diekhans/pycbio/tests/progtests/sra/input/SRX14530460-SraRunInfo.csv

Run | ReleaseDate | LoadDate | spots | bases | spots_with_mates | avgLength | size_MB | AssemblyName | download_path | Experiment | LibraryName | LibraryStrategy | LibrarySelection | LibrarySource | LibraryLayout | InsertSize | InsertDev | Platform | Model | SRAStudy | BioProject | Study_Pubmed_id | ProjectID | Sample | BioSample | SampleType | TaxID | ScientificName | SampleName | g1k_pop_code | source | g1k_analysis_group | Subject_ID | Sex | Disease | Tumor | Affection_Status | Analyte_Type | Histological_Type | Body_Site | CenterName | Submission | dbgap_study_accession | Consent | RunHash | ReadHash
SRR18396502 | 2022-03-22 02:52:43 | 2022-03-21 11:46:57 | 176 | 26686 | 176 | 151 | 0 |  | https://sra-downloadb.be-md.ncbi.nlm.nih.gov/sos9/sra-pub-zq-924/SRR018/18396/SRR18396502/SRR18396502.lite.1 | SRX14530460 | pYES_BRCA_A_pH3 | RNA-Seq | RANDOM | TRANSCRIPTOMIC | PAIRED | 0 | 0 | ILLUMINA | NextSeq 500 | SRP365043 | PRJNA818194 |  | 818194 | SRS12327854 | SAMN26849332 | simple | 4932 | Saccharomyces cerevisiae | pYES_BRCA_A_pH3 |  |  |  |  |  |  | no |  |  |  |  | NATIONAL RESEARCH COUNCIL OF ITALY (CNR) | SRA1388950 |  | public | F7598EDAF03B7869CC7042EFEC8C694F | 543D294AB70618099D481EB79116D204
