diekhans/pycbio/tests/progtests/sra/input/SRX2013614-SraRunInfo.tsv

Run | ReleaseDate | LoadDate | spots | bases | spots_with_mates | avgLength | size_MB | AssemblyName | download_path | Experiment | LibraryName | LibraryStrategy | LibrarySelection | LibrarySource | LibraryLayout | InsertSize | InsertDev | Platform | Model | SRAStudy | BioProject | Study_Pubmed_id | ProjectID | Sample | BioSample | SampleType | TaxID | ScientificName | SampleName | g1k_pop_code | source | g1k_analysis_group | Subject_ID | Sex | Disease | Tumor | Affection_Status | Analyte_Type | Histological_Type | Body_Site | CenterName | Submission | dbgap_study_accession | Consent | RunHash | ReadHash
SRR4020133 | 2020-04-17 16:24:12 | 2016-11-01 14:22:40 | 393 | 39300 | 0 | 100 | 0 |  | https://sra-downloadb.be-md.ncbi.nlm.nih.gov/sos9/sra-pub-zq-922/SRR004/020/SRR4020133.sralite.1 | SRX2013614 |  | RNA-Seq | cDNA | TRANSCRIPTOMIC | SINGLE | 0 | 0 | ILLUMINA | Illumina HiSeq 2000 | SRP066860 | PRJNA304636 | 2 | 304636 | SRS1610588 | SAMN05560693 | simple | 4932 | Saccharomyces cerevisiae | GSM2268808 |  |  |  |  |  |  | no |  |  |  |  | GEO | SRA314391 |  | public | DBCDDD40115BEA512B414762005C0D5A | 3C6D3D4D87669E3AC93E930605D94CEF
