diekhans/pycbio/tests/progtests/csv-to-tsv/input/sra-run-semi.csv

Run | ReleaseDate | LoadDate | spots | bases | spots_with_mates | avgLength | size_MB | AssemblyName | download_path | Experiment | LibraryName | LibraryStrategy | LibrarySelection | LibrarySource | LibraryLayout | InsertSize | InsertDev | Platform | Model | SRAStudy | BioProject | Study_Pubmed_id | ProjectID | Sample | BioSample | SampleType | TaxID | ScientificName | SampleName | g1k_pop_code | source | g1k_analysis_group | Subject_ID | Sex | Disease | Tumor | Affection_Status | Analyte_Type | Histological_Type | Body_Site | CenterName | Submission | dbgap_study_accession | Consent | RunHash | ReadHash
DRR030359 | 2017-02-28 | 2017-02-28 | 67386940 | 6806080940 | 0 | 101 | 4206 |  | https://sra-download.ncbi.nlm.nih.gov/srapub/DRR030359 | DRX027375 | RNA-seq of F2-4A mouse liver | RNA-Seq | cDNA | TRANSCRIPTOMIC | SINGLE | 0 | 0 | ILLUMINA | Illumina HiSeq 2000 | DRP003496 | PRJDB3525 |  | 368837 | DRS041181 | SAMD00026056 | simple | 10090 | Mus musculus | SAMD00026056 |  |  |  |  | male |  | no |  |  |  |  | NAGOYA | DRA003057 |  | public | A9EF6C7C9B6BA92CF5AF50D536C88866 | 65BE9BBF3D7D514DF2FD9F9DA25957C1
DRR030360 | 2017-02-28 | 2017-02-28 | 59278224 | 5987100624 | 0 | 101 | 3702 |  | https://sra-download.ncbi.nlm.nih.gov/srapub/DRR030360 | DRX027376 | RNA-seq of F2-4B mouse liver | RNA-Seq | cDNA | TRANSCRIPTOMIC | SINGLE | 0 | 0 | ILLUMINA | Illumina HiSeq 2000 | DRP003496 | PRJDB3525 |  | 368837 | DRS041182 | SAMD00026057 | simple | 10090 | Mus musculus | SAMD00026057 |  |  |  |  | male |  | no |  |  |  |  | NAGOYA | DRA003057 |  | public | 67EC2E6DB3629CE509964D6E7BF2C341 | 3788A7E7B8208792A841A63F96753AA1
DRR030361 | 2017-02-28 | 2017-02-28 | 73682031 | 7441885131 | 0 | 101 | 4599 |  | https://sra-download.ncbi.nlm.nih.gov/srapub/DRR030361 | DRX027377 | RNA-seq of F2-4D mouse liver | RNA-Seq | cDNA | TRANSCRIPTOMIC | SINGLE | 0 | 0 | ILLUMINA | Illumina HiSeq 2000 | DRP003496 | PRJDB3525 |  | 368837 | DRS041183 | SAMD00026058 | simple | 10090 | Mus musculus | SAMD00026058 |  |  |  |  | male |  | no |  |  |  |  | NAGOYA | DRA003057 |  | public | 5F72EDE34E3DF5FE5D215526F7F37DA9 | 6054E11B177B0662218E2DFAC80FE5D6
DRR030362 | 2017-02-28 | 2017-02-28 | 69622818 | 7031904618 | 0 | 101 | 4391 |  | https://sra-download.ncbi.nlm.nih.gov/srapub/DRR030362 | DRX027378 | RNA-seq of F2-4A5C21A pooled mouse gonadal fat pads | RNA-Seq | cDNA | TRANSCRIPTOMIC | SINGLE | 0 | 0 | ILLUMINA | Illumina HiSeq 2000 | DRP003496 | PRJDB3525 |  | 368837 | DRS041184 | SAMD00026059 | simple | 10090 | Mus musculus | SAMD00026059 |  |  |  |  | male |  | no |  |  |  |  | NAGOYA | DRA003057 |  | public | CE63E1D090AE9165CD200755D6786BE2 | DAAA783AF21215D5C712F64F52BB260B
DRR030363 | 2017-02-28 | 2017-02-28 | 83051167 | 8388167867 | 0 | 101 | 5229 |  | https://sra-download.ncbi.nlm.nih.gov/srapub/DRR030363 | DRX027379 | RNA-seq of F2-4B5A21B mouse pooled gonadal fat pads | RNA-Seq | cDNA | TRANSCRIPTOMIC | SINGLE | 0 | 0 | ILLUMINA | Illumina HiSeq 2000 | DRP003496 | PRJDB3525 |  | 368837 | DRS041185 | SAMD00026060 | simple | 10090 | Mus musculus | SAMD00026060 |  |  |  |  | male |  | no |  |  |  |  | NAGOYA | DRA003057 |  | public | C6BF1D1B9DEFED534A11972ED241C485 | 16D035E735B4D057D60C4FBA0FE3367D
DRR030364 | 2017-02-28 | 2017-02-28 | 52629776 | 5315607376 | 0 | 101 | 3333 |  | https://sra-download.ncbi.nlm.nih.gov/srapub/DRR030364 | DRX027380 | RNA-seq of F2-4D5B21C mouse pooled gonadal fat pads | RNA-Seq | cDNA | TRANSCRIPTOMIC | SINGLE | 0 | 0 | ILLUMINA | Illumina HiSeq 2000 | DRP003496 | PRJDB3525 |  | 368837 | DRS041186 | SAMD00026061 | simple | 10090 | Mus musculus | SAMD00026061 |  |  |  |  | male |  | no |  |  |  |  | NAGOYA | DRA003057 |  | public | 043E079DE11792123B221DAC8B3CF050 | B0D448B5A3701469AABD93E959F1597E
DRR030403 | 2017-02-28 | 2017-02-28 | 30977007 | 6257355414 | 30977007 | 202 | 4125 |  | https://sra-download.ncbi.nlm.nih.gov/srapub/DRR030403 | DRX027419 | Mouse embryonic stem cells exposed to p-DCB | RNA-Seq | RANDOM | TRANSCRIPTOMIC | PAIRED | 200 | 0 | ILLUMINA | Illumina HiSeq 2000 | DRP003476 | PRJDB3516 |  | 375918 | DRS041039 | SAMD00026224 | simple | 10090 | Mus musculus | SAMD00026224 |  |  |  |  | male |  | no |  |  |  |  | AIST | DRA003065 |  | public | B8D906BE71B279512D06296E527EB84D | B0EC587F73F5D2B26CAB08C98E7AD8DF
DRR030404 | 2017-02-28 | 2017-02-28 | 44267986 | 8942133172 | 44267986 | 202 | 5602 |  | https://sra-download.ncbi.nlm.nih.gov/srapub/DRR030404 | DRX027420 | Mouse embryonic stem cells exposed to p-DCB | RNA-Seq | RANDOM | TRANSCRIPTOMIC | PAIRED | 200 | 0 | ILLUMINA | Illumina HiSeq 2000 | DRP003476 | PRJDB3516 |  | 375918 | DRS041040 | SAMD00026225 | simple | 10090 | Mus musculus | SAMD00026225 |  |  |  |  | male |  | no |  |  |  |  | AIST | DRA003065 |  | public | 19C72E4B6412F2EE6384A9BFD42AD8F1 | 4DDC54A62C3C6853995E541F08011AF8
DRR030405 | 2017-02-28 | 2017-02-28 | 30473895 | 6155726790 | 30473895 | 202 | 3843 |  | https://sra-download.ncbi.nlm.nih.gov/srapub/DRR030405 | DRX027421 | Mouse embryonic stem cells exposed to p-DCB | RNA-Seq | RANDOM | TRANSCRIPTOMIC | PAIRED | 200 | 0 | ILLUMINA | Illumina HiSeq 2000 | DRP003476 | PRJDB3516 |  | 375918 | DRS041041 | SAMD00026226 | simple | 10090 | Mus musculus | SAMD00026226 |  |  |  |  | male |  | no |  |  |  |  | AIST | DRA003065 |  | public | B3F0F26813CB275A0B6D0A0AFB2ABE26 | CCED742E79A3F0D0BBD72224F35FDDCB
DRR030406 | 2017-02-28 | 2017-02-28 | 41774744 | 8438498288 | 41774744 | 202 | 5561 |  | https://sra-download.ncbi.nlm.nih.gov/srapub/DRR030406 | DRX027422 | Mouse embryonic stem cells exposed to p-DCB | RNA-Seq | RANDOM | TRANSCRIPTOMIC | PAIRED | 200 | 0 | ILLUMINA | Illumina HiSeq 2000 | DRP003476 | PRJDB3516 |  | 375918 | DRS041042 | SAMD00026227 | simple | 10090 | Mus musculus | SAMD00026227 |  |  |  |  | male |  | no |  |  |  |  | AIST | DRA003065 |  | public | 82CB036F26A21C366ED9ED5D5EF80336 | B58FD251C068A376AF0188D0F556FA5C
DRR030407 | 2017-02-28 | 2017-02-28 | 32214045 | 6507237090 | 32214045 | 202 | 4267 |  | https://sra-download.ncbi.nlm.nih.gov/srapub/DRR030407 | DRX027423 | Mouse embryonic stem cells exposed to p-DCB | RNA-Seq | RANDOM | TRANSCRIPTOMIC | PAIRED | 200 | 0 | ILLUMINA | Illumina HiSeq 2000 | DRP003476 | PRJDB3516 |  | 375918 | DRS041043 | SAMD00026228 | simple | 10090 | Mus musculus | SAMD00026228 |  |  |  |  | male |  | no |  |  |  |  | AIST | DRA003065 |  | public | 0F7CF206CDC43FAC9C19B92023FA8DE8 | A16015A0D5D1B24A15DCDB99592F73C2
DRR030408 | 2017-02-28 | 2017-02-28 | 37137309 | 7501736418 | 37137309 | 202 | 4942 |  | https://sra-download.ncbi.nlm.nih.gov/srapub/DRR030408 | DRX027424 | Mouse embryonic stem cells exposed to p-DCB | RNA-Seq | RANDOM | TRANSCRIPTOMIC | PAIRED | 200 | 0 | ILLUMINA | Illumina HiSeq 2000 | DRP003476 | PRJDB3516 |  | 375918 | DRS041044 | SAMD00026229 | simple | 10090 | Mus musculus | SAMD00026229 |  |  |  |  | male |  | no |  |  |  |  | AIST | DRA003065 |  | public | 7B050B6A07046EE08492093827C53CB5 | 9540D8496598CAB2D9B92B6889891E1E
DRR030409 | 2017-02-28 | 2017-02-28 | 30688033 | 6198982666 | 30688033 | 202 | 3840 |  | https://sra-download.ncbi.nlm.nih.gov/srapub/DRR030409 | DRX027425 | Mouse embryonic stem cells exposed to p-DCB | RNA-Seq | RANDOM | TRANSCRIPTOMIC | PAIRED | 200 | 0 | ILLUMINA | Illumina HiSeq 2000 | DRP003476 | PRJDB3516 |  | 375918 | DRS041045 | SAMD00026230 | simple | 10090 | Mus musculus | SAMD00026230 |  |  |  |  | male |  | no |  |  |  |  | AIST | DRA003065 |  | public | 4712494C8A6A20F59CF1F177153B8E5B | 3990B589E256D597C11A7C0EE7A34FC1
DRR030410 | 2017-02-28 | 2017-02-28 | 31631058 | 6389473716 | 31631058 | 202 | 3974 |  | https://sra-download.ncbi.nlm.nih.gov/srapub/DRR030410 | DRX027426 | Mouse embryonic stem cells exposed to p-DCB | RNA-Seq | RANDOM | TRANSCRIPTOMIC | PAIRED | 200 | 0 | ILLUMINA | Illumina HiSeq 2000 | DRP003476 | PRJDB3516 |  | 375918 | DRS041046 | SAMD00026231 | simple | 10090 | Mus musculus | SAMD00026231 |  |  |  |  | male |  | no |  |  |  |  | AIST | DRA003065 |  | public | 648B0D913859F41D321E44245E8CF6B2 | 881E8981EDC6FA3C1B0D9201E7FAB84E
DRR051357 | 2017-02-28 | 2017-02-28 | 33459036 | 1204525296 | 0 | 36 | 598 |  | https://sra-download.ncbi.nlm.nih.gov/srapub/DRR051357 | DRX046249 |  | RNA-Seq | cDNA | TRANSCRIPTOMIC | SINGLE | 0 | 0 | ILLUMINA | Illumina Genome Analyzer IIx | DRP003489 | PRJDB4477 |  | 376153 | DRS041060 | SAMD00045276 | simple | 10090 | Mus musculus | SAMD00045276 |  |  |  |  |  |  | no |  |  |  |  | HIROSHIMA | DRA004283 |  | public | 5ADF18D6D67F43321CEED2B1791EB740 | FD5AE4873C019F1D491A7262AD0F48A8
DRR051358 | 2017-02-28 | 2017-02-28 | 24320514 | 875538504 | 0 | 36 | 406 |  | https://sra-download.ncbi.nlm.nih.gov/srapub/DRR051358 | DRX046250 |  | RNA-Seq | cDNA | TRANSCRIPTOMIC | SINGLE | 0 | 0 | ILLUMINA | Illumina Genome Analyzer IIx | DRP003489 | PRJDB4477 |  | 376153 | DRS041061 | SAMD00045277 | simple | 10090 | Mus musculus | SAMD00045277 |  |  |  |  |  |  | no |  |  |  |  | HIROSHIMA | DRA004283 |  | public | 0FC3A87807D2DB5D879AFB9D021C9F5F | 82706BD2E0EA0303DB8B649A834C8D61
ERR1745401 | 2017-02-28 | 2017-02-28 | 54471972 | 2723598600 | 0 | 50 | 1170 |  | https://sra-download.ncbi.nlm.nih.gov/srapub/ERR1745401 | ERX1814615 | T0_2i_rRNA_s | RNA-Seq | Inverse rRNA | TRANSCRIPTOMIC | SINGLE | 0 | 0 | ILLUMINA | Illumina Genome Analyzer IIx | ERP020389 | PRJEB18460 |  | 376717 | ERS1463303 | SAMEA18891418 | simple | 10090 | Mus musculus | house mouse |  |  |  |  |  |  | no |  |  |  |  | Stunnenberg | ERA770777 |  | public | E0B9FD26C5352C601F8B5178D8ABBBB5 | CC6E0B25B15CFA08A68AA6D4F10CEE58
ERR1745402 | 2017-02-28 | 2017-02-28 | 50534105 | 2526705250 | 0 | 50 | 1089 |  | https://sra-download.ncbi.nlm.nih.gov/srapub/ERR1745402 | ERX1814616 | T1_16h_rRNA_s | RNA-Seq | Inverse rRNA | TRANSCRIPTOMIC | SINGLE | 0 | 0 | ILLUMINA | Illumina Genome Analyzer IIx | ERP020389 | PRJEB18460 |  | 376717 | ERS1463304 | SAMEA18892168 | simple | 10090 | Mus musculus | house mouse |  |  |  |  |  |  | no |  |  |  |  | Stunnenberg | ERA770777 |  | public | 327B5B421C1D11B259C51929BF9C32BE | 23012873842542BD4418444E83A601D9
ERR1745403 | 2017-02-28 | 2017-02-28 | 49251393 | 2462569650 | 0 | 50 | 1059 |  | https://sra-download.ncbi.nlm.nih.gov/srapub/ERR1745403 | ERX1814617 | T2_Rex1high_rRNA_s | RNA-Seq | Inverse rRNA | TRANSCRIPTOMIC | SINGLE | 0 | 0 | ILLUMINA | Illumina Genome Analyzer IIx | ERP020389 | PRJEB18460 |  | 376717 | ERS1463305 | SAMEA18892918 | simple | 10090 | Mus musculus | house mouse |  |  |  |  |  |  | no |  |  |  |  | Stunnenberg | ERA770777 |  | public | 91AC49806492D344C6AE47D3F927BF5E | AB5865F4CA1589C22D7764C99C9FFE7B
ERR1745404 | 2017-02-28 | 2017-02-28 | 48733321 | 2436666050 | 0 | 50 | 1051 |  | https://sra-download.ncbi.nlm.nih.gov/srapub/ERR1745404 | ERX1814618 | T2_Rex1low_rRNA_s | RNA-Seq | Inverse rRNA | TRANSCRIPTOMIC | SINGLE | 0 | 0 | ILLUMINA | Illumina Genome Analyzer IIx | ERP020389 | PRJEB18460 |  | 376717 | ERS1463306 | SAMEA18893668 | simple | 10090 | Mus musculus | house mouse |  |  |  |  |  |  | no |  |  |  |  | Stunnenberg | ERA770777 |  | public | 79C45E75887D14B602FB5C6A9819CDD8 | C58649A36B3090B768E1A8AF10048EB2
ERR1745405 | 2017-02-28 | 2017-02-28 | 30868986 | 1080414510 | 0 | 35 | 1227 |  | https://sra-download.ncbi.nlm.nih.gov/srapub/ERR1745405 | ERX1814619 | T0_2i_polyA_s | RNA-Seq | Oligo-dT | TRANSCRIPTOMIC | SINGLE | 0 | 0 | ILLUMINA | Illumina Genome Analyzer IIx | ERP020389 | PRJEB18460 |  | 376717 | ERS1463307 | SAMEA18894418 | simple | 10090 | Mus musculus | house mouse |  |  |  |  |  |  | no |  |  |  |  | Stunnenberg | ERA770777 |  | public | C33A70992316F4C4ABBF6110B50F99D4 | 8BAD599B7EFC9ED9BB0F1E23C75EB23B
ERR1745406 | 2017-02-28 | 2017-02-28 | 28173501 | 986072535 | 0 | 35 | 1090 |  | https://sra-download.ncbi.nlm.nih.gov/srapub/ERR1745406 | ERX1814620 | T1_16h_polyA_s | RNA-Seq | Oligo-dT | TRANSCRIPTOMIC | SINGLE | 0 | 0 | ILLUMINA | Illumina Genome Analyzer IIx | ERP020389 | PRJEB18460 |  | 376717 | ERS1463308 | SAMEA18895168 | simple | 10090 | Mus musculus | house mouse |  |  |  |  |  |  | no |  |  |  |  | Stunnenberg | ERA770777 |  | public | 90C3736CF9670C8FDE02B3264BE1EB94 | 79FF20D2A53EB2C6DE979A948C815530
ERR1745407 | 2017-02-28 | 2017-02-28 | 25362653 | 887692855 | 0 | 35 | 972 |  | https://sra-download.ncbi.nlm.nih.gov/srapub/ERR1745407 | ERX1814621 | T2_Rex1high_polyA_s | RNA-Seq | Oligo-dT | TRANSCRIPTOMIC | SINGLE | 0 | 0 | ILLUMINA | Illumina Genome Analyzer IIx | ERP020389 | PRJEB18460 |  | 376717 | ERS1463309 | SAMEA18895918 | simple | 10090 | Mus musculus | house mouse |  |  |  |  |  |  | no |  |  |  |  | Stunnenberg | ERA770777 |  | public | D19003AAC88B36C5824887B72ECCD9FB | 16AECB2E2EDF705F261346F84B7496F0
ERR1745408 | 2017-02-28 | 2017-02-28 | 24241853 | 848464855 | 0 | 35 | 938 |  | https://sra-download.ncbi.nlm.nih.gov/srapub/ERR1745408 | ERX1814622 | T2_Rex1low_polyA_s | RNA-Seq | Oligo-dT | TRANSCRIPTOMIC | SINGLE | 0 | 0 | ILLUMINA | Illumina Genome Analyzer IIx | ERP020389 | PRJEB18460 |  | 376717 | ERS1463310 | SAMEA18896668 | simple | 10090 | Mus musculus | house mouse |  |  |  |  |  |  | no |  |  |  |  | Stunnenberg | ERA770777 |  | public | 53EE181A4F66B15FC16B7CF67FAA8403 | 8346835212ADE75314C17C24A5BE4DE9
ERR1813629 | 2017-02-22 | 2017-02-24 | 23406637 | 2949236262 | 0 | 126 | 1014 |  | https://sra-download.ncbi.nlm.nih.gov/srapub/ERR1813629 | ERX1876166 | Sample 1_s | RNA-Seq | RANDOM PCR | TRANSCRIPTOMIC | SINGLE | 0 | 0 | ILLUMINA | Illumina HiSeq 4000 | ERP021240 | PRJEB19251 |  | 376299 | ERS1531700 | SAMEA70189168 | simple | 10090 | Mus musculus | house mouse |  |  |  |  |  |  | no |  |  |  |  | Sabine Spath, Florian Mair | ERA804242 |  | public | 27F76AE2FB1D4D9D9527CC4F34D57D4C | 00E53A6D43E34410FD92E927D4165368
ERR1813630 | 2017-02-22 | 2017-02-24 | 19059035 | 2401438410 | 0 | 126 | 824 |  | https://sra-download.ncbi.nlm.nih.gov/srapub/ERR1813630 | ERX1876167 | Sample 10_s | RNA-Seq | RANDOM PCR | TRANSCRIPTOMIC | SINGLE | 0 | 0 | ILLUMINA | Illumina HiSeq 4000 | ERP021240 | PRJEB19251 |  | 376299 | ERS1531701 | SAMEA70189918 | simple | 10090 | Mus musculus | house mouse |  |  |  |  |  |  | no |  |  |  |  | Sabine Spath, Florian Mair | ERA804242 |  | public | 61A0360CEAEE64B2E77C5F2029DF6020 | DA47B29AE64DE9F2C839AD0679D0922D
ERR1813631 | 2017-02-22 | 2017-02-24 | 22985083 | 2896120458 | 0 | 126 | 1000 |  | https://sra-download.ncbi.nlm.nih.gov/srapub/ERR1813631 | ERX1876168 | Sample 11_s | RNA-Seq | RANDOM PCR | TRANSCRIPTOMIC | SINGLE | 0 | 0 | ILLUMINA | Illumina HiSeq 4000 | ERP021240 | PRJEB19251 |  | 376299 | ERS1531702 | SAMEA70190668 | simple | 10090 | Mus musculus | house mouse |  |  |  |  |  |  | no |  |  |  |  | Sabine Spath, Florian Mair | ERA804242 |  | public | 96E908FE4834A672C34C88D77DB03CBA | 863BEC0DFA3B775FAC696BCDD07C638B
ERR1813632 | 2017-02-22 | 2017-02-24 | 31039729 | 3911005854 | 0 | 126 | 1339 |  | https://sra-download.ncbi.nlm.nih.gov/srapub/ERR1813632 | ERX1876169 | Sample 12_s | RNA-Seq | RANDOM PCR | TRANSCRIPTOMIC | SINGLE | 0 | 0 | ILLUMINA | Illumina HiSeq 4000 | ERP021240 | PRJEB19251 |  | 376299 | ERS1531703 | SAMEA70191418 | simple | 10090 | Mus musculus | house mouse |  |  |  |  |  |  | no |  |  |  |  | Sabine Spath, Florian Mair | ERA804242 |  | public | F554B8264332854A8053B117D12F21A5 | 2160CBCD12BB1F0809BA74E1875C989F
ERR1813633 | 2017-02-22 | 2017-02-22 | 0 | 0 | 0 | 0 | 0 |  |  | ERX1876170 | Sample 13_s | RNA-Seq | RANDOM PCR | TRANSCRIPTOMIC | SINGLE | 0 | 0 | ILLUMINA | Illumina HiSeq 4000 | ERP021240 | PRJEB19251 |  | 376299 | ERS1531704 | SAMEA70192168 | simple | 10090 | Mus musculus | house mouse |  |  |  |  |  |  | no |  |  |  |  | Sabine Spath, Florian Mair | ERA804242 |  | public
ERR1813634 | 2017-02-22 | 2017-02-24 | 21614397 | 2723414022 | 0 | 126 | 933 |  | https://sra-download.ncbi.nlm.nih.gov/srapub/ERR1813634 | ERX1876171 | Sample 14_s | RNA-Seq | RANDOM PCR | TRANSCRIPTOMIC | SINGLE | 0 | 0 | ILLUMINA | Illumina HiSeq 4000 | ERP021240 | PRJEB19251 |  | 376299 | ERS1531705 | SAMEA70192918 | simple | 10090 | Mus musculus | house mouse |  |  |  |  |  |  | no |  |  |  |  | Sabine Spath, Florian Mair | ERA804242 |  | public | DC80D5D3675F8F5B6F9D663286739043 | A880C57371FB07F63CFC6DAAC3A1C952
ERR1813635 | 2017-02-22 | 2017-02-24 | 23276491 | 2932837866 | 0 | 126 | 1014 |  | https://sra-download.ncbi.nlm.nih.gov/srapub/ERR1813635 | ERX1876172 | Sample 15_s | RNA-Seq | RANDOM PCR | TRANSCRIPTOMIC | SINGLE | 0 | 0 | ILLUMINA | Illumina HiSeq 4000 | ERP021240 | PRJEB19251 |  | 376299 | ERS1531706 | SAMEA70193668 | simple | 10090 | Mus musculus | house mouse |  |  |  |  |  |  | no |  |  |  |  | Sabine Spath, Florian Mair | ERA804242 |  | public | C8FCD3188BBCF75F4D64EF79C0A24192 | 233C9A9B85A38E113E319D00CA7AB678
ERR1813636 | 2017-02-22 | 2017-02-24 | 24888387 | 3135936762 | 0 | 126 | 1073 |  | https://sra-download.ncbi.nlm.nih.gov/srapub/ERR1813636 | ERX1876173 | Sample 2_s | RNA-Seq | RANDOM PCR | TRANSCRIPTOMIC | SINGLE | 0 | 0 | ILLUMINA | Illumina HiSeq 4000 | ERP021240 | PRJEB19251 |  | 376299 | ERS1531707 | SAMEA70194418 | simple | 10090 | Mus musculus | house mouse |  |  |  |  |  |  | no |  |  |  |  | Sabine Spath, Florian Mair | ERA804242 |  | public | 091BE68E489E757A7459EDCEB433612E | 131F7F531C5C6896DBE2900880871584
ERR1813637 | 2017-02-22 | 2017-02-24 | 19853672 | 2501562672 | 0 | 126 | 857 |  | https://sra-download.ncbi.nlm.nih.gov/srapub/ERR1813637 | ERX1876174 | Sample 3_s | RNA-Seq | RANDOM PCR | TRANSCRIPTOMIC | SINGLE | 0 | 0 | ILLUMINA | Illumina HiSeq 4000 | ERP021240 | PRJEB19251 |  | 376299 | ERS1531708 | SAMEA70195168 | simple | 10090 | Mus musculus | house mouse |  |  |  |  |  |  | no |  |  |  |  | Sabine Spath, Florian Mair | ERA804242 |  | public | 177BE77A02C02FED3970A4EA2B8ACCB7 | 2C7822D3AC276004A367E842DEF863C6
ERR1813638 | 2017-02-22 | 2017-02-24 | 32704496 | 4120766496 | 0 | 126 | 1434 |  | https://sra-download.ncbi.nlm.nih.gov/srapub/ERR1813638 | ERX1876175 | Sample 4_s | RNA-Seq | RANDOM PCR | TRANSCRIPTOMIC | SINGLE | 0 | 0 | ILLUMINA | Illumina HiSeq 4000 | ERP021240 | PRJEB19251 |  | 376299 | ERS1531709 | SAMEA70195918 | simple | 10090 | Mus musculus | house mouse |  |  |  |  |  |  | no |  |  |  |  | Sabine Spath, Florian Mair | ERA804242 |  | public | 4482D2C561C86F1DCF68ED728A711325 | CA369FD925F8F7187D75BA77EA2E958F
ERR1813639 | 2017-02-22 | 2017-02-24 | 31852025 | 4013355150 | 0 | 126 | 1408 |  | https://sra-download.ncbi.nlm.nih.gov/srapub/ERR1813639 | ERX1876176 | Sample 5_s | RNA-Seq | RANDOM PCR | TRANSCRIPTOMIC | SINGLE | 0 | 0 | ILLUMINA | Illumina HiSeq 4000 | ERP021240 | PRJEB19251 |  | 376299 | ERS1531710 | SAMEA70196668 | simple | 10090 | Mus musculus | house mouse |  |  |  |  |  |  | no |  |  |  |  | Sabine Spath, Florian Mair | ERA804242 |  | public | 743AF927190515BE9420203FFCE71CCF | 3EFC93529E3558024493B5B4646D693A
ERR1813640 | 2017-02-22 | 2017-02-24 | 23150181 | 2916922806 | 0 | 126 | 1001 |  | https://sra-download.ncbi.nlm.nih.gov/srapub/ERR1813640 | ERX1876177 | Sample 6_s | RNA-Seq | RANDOM PCR | TRANSCRIPTOMIC | SINGLE | 0 | 0 | ILLUMINA | Illumina HiSeq 4000 | ERP021240 | PRJEB19251 |  | 376299 | ERS1531711 | SAMEA70197418 | simple | 10090 | Mus musculus | house mouse |  |  |  |  |  |  | no |  |  |  |  | Sabine Spath, Florian Mair | ERA804242 |  | public | 4676C949BBFCD59406EBC287C9AE0166 | E5725E2FB2360BAAE5EE3A4127942C0F
ERR1813641 | 2017-02-22 | 2017-02-24 | 21325633 | 2687029758 | 0 | 126 | 933 |  | https://sra-download.ncbi.nlm.nih.gov/srapub/ERR1813641 | ERX1876178 | Sample 7_s | RNA-Seq | RANDOM PCR | TRANSCRIPTOMIC | SINGLE | 0 | 0 | ILLUMINA | Illumina HiSeq 4000 | ERP021240 | PRJEB19251 |  | 376299 | ERS1531712 | SAMEA70198168 | simple | 10090 | Mus musculus | house mouse |  |  |  |  |  |  | no |  |  |  |  | Sabine Spath, Florian Mair | ERA804242 |  | public | 5AA9CD6F9D1B4FF85D946CBA1DC59200 | E19A7A4615DE1FEB3480FC22FFC2A149
ERR1813642 | 2017-02-22 | 2017-02-24 | 27935493 | 3519872118 | 0 | 126 | 1207 |  | https://sra-download.ncbi.nlm.nih.gov/srapub/ERR1813642 | ERX1876179 | Sample 8_s | RNA-Seq | RANDOM PCR | TRANSCRIPTOMIC | SINGLE | 0 | 0 | ILLUMINA | Illumina HiSeq 4000 | ERP021240 | PRJEB19251 |  | 376299 | ERS1531713 | SAMEA70198918 | simple | 10090 | Mus musculus | house mouse |  |  |  |  |  |  | no |  |  |  |  | Sabine Spath, Florian Mair | ERA804242 |  | public | F28D16553635121CD39E9512DAEBFE8F | B81F8CB71362DD41CFA8DAB01A9B39F6
ERR1813643 | 2017-02-22 | 2017-02-24 | 21224074 | 2674233324 | 0 | 126 | 918 |  | https://sra-download.ncbi.nlm.nih.gov/srapub/ERR1813643 | ERX1876180 | Sample 9_s | RNA-Seq | RANDOM PCR | TRANSCRIPTOMIC | SINGLE | 0 | 0 | ILLUMINA | Illumina HiSeq 4000 | ERP021240 | PRJEB19251 |  | 376299 | ERS1531714 | SAMEA70199668 | simple | 10090 | Mus musculus | house mouse |  |  |  |  |  |  | no |  |  |  |  | Sabine Spath, Florian Mair | ERA804242 |  | public | 26126EFFE80F8DEDED1A71CFCEF7A872 | 5AA887E15BF6BA013400FEDCD5C27EA8
ERR1827108 | 2017-02-21 | 2017-02-24 | 2862461 | 715615250 | 2862461 | 250 | 350 |  | https://sra-download.ncbi.nlm.nih.gov/srapub/ERR1827108 | ERX1889267 | do7528_p | RNA-Seq | cDNA | TRANSCRIPTOMIC | PAIRED | 737 | 479.787 | ILLUMINA | Illumina HiSeq 2500 | ERP016428 | PRJEB14760 |  | 330944 | ERS1549247 | SAMEA83349418 | simple | 10092 | Mus musculus domesticus | western European house mouse |  |  |  |  | male |  | no |  |  |  |  | CRUK Cambridge Institute Genomics Core Facility | ERA809577 |  | public | E03B6A99BB018B644E3985C2F378FECF | 1B33737649A487BF9B80B6A48DC92C99
ERR1827109 | 2017-02-21 | 2017-02-24 | 2854130 | 713532500 | 2854130 | 250 | 357 |  | https://sra-download.ncbi.nlm.nih.gov/srapub/ERR1827109 | ERX1889268 | do7529_p | RNA-Seq | cDNA | TRANSCRIPTOMIC | PAIRED | 737 | 479.787 | ILLUMINA | Illumina HiSeq 2500 | ERP016428 | PRJEB14760 |  | 330944 | ERS1549248 | SAMEA83350168 | simple | 10092 | Mus musculus domesticus | western European house mouse |  |  |  |  | male |  | no |  |  |  |  | CRUK Cambridge Institute Genomics Core Facility | ERA809577 |  | public | 783AB1B85D01C297B10F867BC5438397 | D170E5017629E99C374BBFCC37D88FF3
ERR1827110 | 2017-02-21 | 2017-02-24 | 3351296 | 837824000 | 3351296 | 250 | 416 |  | https://sra-download.ncbi.nlm.nih.gov/srapub/ERR1827110 | ERX1889269 | do7530_p | RNA-Seq | cDNA | TRANSCRIPTOMIC | PAIRED | 737 | 479.787 | ILLUMINA | Illumina HiSeq 2500 | ERP016428 | PRJEB14760 |  | 330944 | ERS1549249 | SAMEA83350918 | simple | 10092 | Mus musculus domesticus | western European house mouse |  |  |  |  | male |  | no |  |  |  |  | CRUK Cambridge Institute Genomics Core Facility | ERA809577 |  | public | B2FF24F5BE6200976BF431DD2445C747 | 6EB3F0C99415F3C29E866474D953CED7
ERR1827111 | 2017-02-21 | 2017-02-24 | 228856 | 57214000 | 228856 | 250 | 28 |  | https://sra-download.ncbi.nlm.nih.gov/srapub/ERR1827111 | ERX1889270 | do7531_p | RNA-Seq | cDNA | TRANSCRIPTOMIC | PAIRED | 737 | 479.787 | ILLUMINA | Illumina HiSeq 2500 | ERP016428 | PRJEB14760 |  | 330944 | ERS1549250 | SAMEA83351668 | simple | 10092 | Mus musculus domesticus | western European house mouse |  |  |  |  | male |  | no |  |  |  |  | CRUK Cambridge Institute Genomics Core Facility | ERA809577 |  | public | A4F06632698162780E225D4780D1DD8F | 4733EE8B7973C9DF0237816C4A4903B4
ERR1827112 | 2017-02-21 | 2017-02-24 | 2408739 | 602184750 | 2408739 | 250 | 301 |  | https://sra-download.ncbi.nlm.nih.gov/srapub/ERR1827112 | ERX1889271 | do7532_p | RNA-Seq | cDNA | TRANSCRIPTOMIC | PAIRED | 737 | 479.787 | ILLUMINA | Illumina HiSeq 2500 | ERP016428 | PRJEB14760 |  | 330944 | ERS1549251 | SAMEA83352418 | simple | 10092 | Mus musculus domesticus | western European house mouse |  |  |  |  | male |  | no |  |  |  |  | CRUK Cambridge Institute Genomics Core Facility | ERA809577 |  | public | 712233DDABD0364DF18A347BD73D5552 | 12477ED062036F48058CD5DB1FBC5A41
ERR1827113 | 2017-02-21 | 2017-02-24 | 2955995 | 738998750 | 2955995 | 250 | 365 |  | https://sra-download.ncbi.nlm.nih.gov/srapub/ERR1827113 | ERX1889272 | do7533_p | RNA-Seq | cDNA | TRANSCRIPTOMIC | PAIRED | 737 | 479.787 | ILLUMINA | Illumina HiSeq 2500 | ERP016428 | PRJEB14760 |  | 330944 | ERS1549252 | SAMEA83353168 | simple | 10092 | Mus musculus domesticus | western European house mouse |  |  |  |  | male |  | no |  |  |  |  | CRUK Cambridge Institute Genomics Core Facility | ERA809577 |  | public | 8AEB1B5D31974A6CBDF2290A74299A44 | F0E07F251FEB3ACF23B96C5AECD0CA76
ERR1827114 | 2017-02-21 | 2017-02-24 | 2229356 | 557339000 | 2229356 | 250 | 272 |  | https://sra-download.ncbi.nlm.nih.gov/srapub/ERR1827114 | ERX1889273 | do7534_p | RNA-Seq | cDNA | TRANSCRIPTOMIC | PAIRED | 737 | 479.787 | ILLUMINA | Illumina HiSeq 2500 | ERP016428 | PRJEB14760 |  | 330944 | ERS1549253 | SAMEA83353918 | simple | 10092 | Mus musculus domesticus | western European house mouse |  |  |  |  | male |  | no |  |  |  |  | CRUK Cambridge Institute Genomics Core Facility | ERA809577 |  | public | 8F48D66B97A05B67B230FEB07001B24F | D117F9B9F517AC1B69D768F7B3638FBE
ERR1827115 | 2017-02-21 | 2017-02-24 | 3129365 | 782341250 | 3129365 | 250 | 391 |  | https://sra-download.ncbi.nlm.nih.gov/srapub/ERR1827115 | ERX1889274 | do7535_p | RNA-Seq | cDNA | TRANSCRIPTOMIC | PAIRED | 737 | 479.787 | ILLUMINA | Illumina HiSeq 2500 | ERP016428 | PRJEB14760 |  | 330944 | ERS1549254 | SAMEA83354668 | simple | 10092 | Mus musculus domesticus | western European house mouse |  |  |  |  | male |  | no |  |  |  |  | CRUK Cambridge Institute Genomics Core Facility | ERA809577 |  | public | 93007725342244877A017D7E1D88069D | 67AEC99B19CDBBCBC213B19EB1ADF0E5
ERR1827116 | 2017-02-21 | 2017-02-24 | 2946007 | 736501750 | 2946007 | 250 | 365 |  | https://sra-download.ncbi.nlm.nih.gov/srapub/ERR1827116 | ERX1889275 | do7536_p | RNA-Seq | cDNA | TRANSCRIPTOMIC | PAIRED | 737 | 479.787 | ILLUMINA | Illumina HiSeq 2500 | ERP016428 | PRJEB14760 |  | 330944 | ERS1549255 | SAMEA83355418 | simple | 10092 | Mus musculus domesticus | western European house mouse |  |  |  |  | male |  | no |  |  |  |  | CRUK Cambridge Institute Genomics Core Facility | ERA809577 |  | public | E87E32C7323DF31FEBFC1CE2BC982E51 | 262977FA6619946B9F0C1E72D782C4EE
ERR1827117 | 2017-02-21 | 2017-02-24 | 2734295 | 683573750 | 2734295 | 250 | 343 |  | https://sra-download.ncbi.nlm.nih.gov/srapub/ERR1827117 | ERX1889276 | do7537_p | RNA-Seq | cDNA | TRANSCRIPTOMIC | PAIRED | 737 | 479.787 | ILLUMINA | Illumina HiSeq 2500 | ERP016428 | PRJEB14760 |  | 330944 | ERS1549256 | SAMEA83356168 | simple | 10092 | Mus musculus domesticus | western European house mouse |  |  |  |  | male |  | no |  |  |  |  | CRUK Cambridge Institute Genomics Core Facility | ERA809577 |  | public | D9BA3BAD1EB57B1810B1CBFB18B2A310 | 55CF09BD140C1AC972B632F1E0421706
ERR1827118 | 2017-02-21 | 2017-02-24 | 1706108 | 426527000 | 1706108 | 250 | 223 |  | https://sra-download.ncbi.nlm.nih.gov/srapub/ERR1827118 | ERX1889277 | do7538_p | RNA-Seq | cDNA | TRANSCRIPTOMIC | PAIRED | 737 | 479.787 | ILLUMINA | Illumina HiSeq 2500 | ERP016428 | PRJEB14760 |  | 330944 | ERS1549257 | SAMEA83356918 | simple | 10092 | Mus musculus domesticus | western European house mouse |  |  |  |  | male |  | no |  |  |  |  | CRUK Cambridge Institute Genomics Core Facility | ERA809577 |  | public | 02C5D3DB1F6C254C33B5D8CFCF126A17 | DDD0D5823A1488DCC3D3F80765FAF1F0
ERR1827119 | 2017-02-21 | 2017-02-24 | 1272966 | 318241500 | 1272966 | 250 | 156 |  | https://sra-download.ncbi.nlm.nih.gov/srapub/ERR1827119 | ERX1889278 | do7539_p | RNA-Seq | cDNA | TRANSCRIPTOMIC | PAIRED | 737 | 479.787 | ILLUMINA | Illumina HiSeq 2500 | ERP016428 | PRJEB14760 |  | 330944 | ERS1549258 | SAMEA83357668 | simple | 10092 | Mus musculus domesticus | western European house mouse |  |  |  |  | male |  | no |  |  |  |  | CRUK Cambridge Institute Genomics Core Facility | ERA809577 |  | public | 356FB9CB22B05ADAE4BB9650D0FC954C | BB91BD7323ACD434DF4CF239B8B64BAC
ERR1827120 | 2017-02-21 | 2017-02-24 | 231138 | 57784500 | 231138 | 250 | 29 |  | https://sra-download.ncbi.nlm.nih.gov/srapub/ERR1827120 | ERX1889279 | do7540_p | RNA-Seq | cDNA | TRANSCRIPTOMIC | PAIRED | 737 | 479.787 | ILLUMINA | Illumina HiSeq 2500 | ERP016428 | PRJEB14760 |  | 330944 | ERS1549259 | SAMEA83358418 | simple | 10092 | Mus musculus domesticus | western European house mouse |  |  |  |  | male |  | no |  |  |  |  | CRUK Cambridge Institute Genomics Core Facility | ERA809577 |  | public | 5CED6A8A8CD288C61F87017E109CE524 | 9E25F79F55A9956AC102BE10ED20988B
ERR1827121 | 2017-02-21 | 2017-02-24 | 2821668 | 705417000 | 2821668 | 250 | 354 |  | https://sra-download.ncbi.nlm.nih.gov/srapub/ERR1827121 | ERX1889280 | do7541_p | RNA-Seq | cDNA | TRANSCRIPTOMIC | PAIRED | 737 | 479.787 | ILLUMINA | Illumina HiSeq 2500 | ERP016428 | PRJEB14760 |  | 330944 | ERS1549260 | SAMEA83359168 | simple | 10092 | Mus musculus domesticus | western European house mouse |  |  |  |  | male |  | no |  |  |  |  | CRUK Cambridge Institute Genomics Core Facility | ERA809577 |  | public | 52AECB67FB7F6244144363084AEDBC67 | 2579721D1582BE7E5AD296DFA8970F39
ERR1827122 | 2017-02-21 | 2017-02-24 | 3417396 | 854349000 | 3417396 | 250 | 430 |  | https://sra-download.ncbi.nlm.nih.gov/srapub/ERR1827122 | ERX1889281 | do7542_p | RNA-Seq | cDNA | TRANSCRIPTOMIC | PAIRED | 737 | 479.787 | ILLUMINA | Illumina HiSeq 2500 | ERP016428 | PRJEB14760 |  | 330944 | ERS1549261 | SAMEA83359918 | simple | 10092 | Mus musculus domesticus | western European house mouse |  |  |  |  | male |  | no |  |  |  |  | CRUK Cambridge Institute Genomics Core Facility | ERA809577 |  | public | 8042B00CECE79F02E6AB9EFAEFF7D8AC | D62BF211E8EB2EEC0E04834B5B16CE6C
ERR1827123 | 2017-02-21 | 2017-02-24 | 1865413 | 466353250 | 1865413 | 250 | 231 |  | https://sra-download.ncbi.nlm.nih.gov/srapub/ERR1827123 | ERX1889282 | do7543_p | RNA-Seq | cDNA | TRANSCRIPTOMIC | PAIRED | 737 | 479.787 | ILLUMINA | Illumina HiSeq 2500 | ERP016428 | PRJEB14760 |  | 330944 | ERS1549262 | SAMEA83360668 | simple | 10092 | Mus musculus domesticus | western European house mouse |  |  |  |  | male |  | no |  |  |  |  | CRUK Cambridge Institute Genomics Core Facility | ERA809577 |  | public | B4C4097454685967C1279BCC3903FC29 | B3E11328D9E3ED2A8FFF327FDFD273E9
ERR1827124 | 2017-02-21 | 2017-02-24 | 2457488 | 614372000 | 2457488 | 250 | 309 |  | https://sra-download.ncbi.nlm.nih.gov/srapub/ERR1827124 | ERX1889283 | do7544_p | RNA-Seq | cDNA | TRANSCRIPTOMIC | PAIRED | 737 | 479.787 | ILLUMINA | Illumina HiSeq 2500 | ERP016428 | PRJEB14760 |  | 330944 | ERS1549263 | SAMEA83361418 | simple | 10092 | Mus musculus domesticus | western European house mouse |  |  |  |  | male |  | no |  |  |  |  | CRUK Cambridge Institute Genomics Core Facility | ERA809577 |  | public | B4104FD848A129FBB549FD51BBBF15EE | C7AFED7E6A3124834B85BBB5CF850951
ERR1827125 | 2017-02-21 | 2017-02-24 | 3186537 | 796634250 | 3186537 | 250 | 397 |  | https://sra-download.ncbi.nlm.nih.gov/srapub/ERR1827125 | ERX1889284 | do7545_p | RNA-Seq | cDNA | TRANSCRIPTOMIC | PAIRED | 737 | 479.787 | ILLUMINA | Illumina HiSeq 2500 | ERP016428 | PRJEB14760 |  | 330944 | ERS1549264 | SAMEA83362168 | simple | 10092 | Mus musculus domesticus | western European house mouse |  |  |  |  | male |  | no |  |  |  |  | CRUK Cambridge Institute Genomics Core Facility | ERA809577 |  | public | 87941CE1F99D141994243A74E8134381 | 11B978F118B3368CC45499BDF6B75528
ERR1827126 | 2017-02-21 | 2017-02-24 | 2155617 | 538904250 | 2155617 | 250 | 270 |  | https://sra-download.ncbi.nlm.nih.gov/srapub/ERR1827126 | ERX1889285 | do7546_p | RNA-Seq | cDNA | TRANSCRIPTOMIC | PAIRED | 737 | 479.787 | ILLUMINA | Illumina HiSeq 2500 | ERP016428 | PRJEB14760 |  | 330944 | ERS1549265 | SAMEA83362918 | simple | 10092 | Mus musculus domesticus | western European house mouse |  |  |  |  | male |  | no |  |  |  |  | CRUK Cambridge Institute Genomics Core Facility | ERA809577 |  | public | 94E4C945CE029739FA789FFBA6C3F17B | 1EDF0C034AB5853A6BE31799CC1DE159
ERR1827127 | 2017-02-21 | 2017-02-24 | 292989 | 73247250 | 292989 | 250 | 36 |  | https://sra-download.ncbi.nlm.nih.gov/srapub/ERR1827127 | ERX1889286 | do7547_p | RNA-Seq | cDNA | TRANSCRIPTOMIC | PAIRED | 737 | 479.787 | ILLUMINA | Illumina HiSeq 2500 | ERP016428 | PRJEB14760 |  | 330944 | ERS1549266 | SAMEA83363668 | simple | 10092 | Mus musculus domesticus | western European house mouse |  |  |  |  | male |  | no |  |  |  |  | CRUK Cambridge Institute Genomics Core Facility | ERA809577 |  | public | 086297D03CE21CB7A3A15F4BAC2185BF | 957F54FF155EC796FE5AC91A4EFB5ABB
ERR1827128 | 2017-02-21 | 2017-02-24 | 2895719 | 723929750 | 2895719 | 250 | 357 |  | https://sra-download.ncbi.nlm.nih.gov/srapub/ERR1827128 | ERX1889287 | do7548_p | RNA-Seq | cDNA | TRANSCRIPTOMIC | PAIRED | 737 | 479.787 | ILLUMINA | Illumina HiSeq 2500 | ERP016428 | PRJEB14760 |  | 330944 | ERS1549267 | SAMEA83364418 | simple | 10092 | Mus musculus domesticus | western European house mouse |  |  |  |  | male |  | no |  |  |  |  | CRUK Cambridge Institute Genomics Core Facility | ERA809577 |  | public | 3681EAFC3EC03373FD862002595426F5 | 6B1166DEC37554E927A75BF19EF627D1
ERR1827129 | 2017-02-21 | 2017-02-24 | 365826 | 91456500 | 365826 | 250 | 45 |  | https://sra-download.ncbi.nlm.nih.gov/srapub/ERR1827129 | ERX1889288 | do7549_p | RNA-Seq | cDNA | TRANSCRIPTOMIC | PAIRED | 737 | 479.787 | ILLUMINA | Illumina HiSeq 2500 | ERP016428 | PRJEB14760 |  | 330944 | ERS1549268 | SAMEA83365168 | simple | 10092 | Mus musculus domesticus | western European house mouse |  |  |  |  | male |  | no |  |  |  |  | CRUK Cambridge Institute Genomics Core Facility | ERA809577 |  | public | 963AC78A518720371AD801A747562288 | 2FD10980BEC11F03404198EDE9139EA1
ERR1827130 | 2017-02-21 | 2017-02-24 | 1051910 | 262977500 | 1051910 | 250 | 130 |  | https://sra-download.ncbi.nlm.nih.gov/srapub/ERR1827130 | ERX1889289 | do7550_p | RNA-Seq | cDNA | TRANSCRIPTOMIC | PAIRED | 737 | 479.787 | ILLUMINA | Illumina HiSeq 2500 | ERP016428 | PRJEB14760 |  | 330944 | ERS1549269 | SAMEA83365918 | simple | 10092 | Mus musculus domesticus | western European house mouse |  |  |  |  | male |  | no |  |  |  |  | CRUK Cambridge Institute Genomics Core Facility | ERA809577 |  | public | 0E01E52B7E2E26265CDC27B58875134A | FC168CFF0F46F71B41092DD5111425CA
ERR1827131 | 2017-02-21 | 2017-02-24 | 263826 | 65956500 | 263826 | 250 | 32 |  | https://sra-download.ncbi.nlm.nih.gov/srapub/ERR1827131 | ERX1889290 | do7551_p | RNA-Seq | cDNA | TRANSCRIPTOMIC | PAIRED | 737 | 479.787 | ILLUMINA | Illumina HiSeq 2500 | ERP016428 | PRJEB14760 |  | 330944 | ERS1549270 | SAMEA83366668 | simple | 10092 | Mus musculus domesticus | western European house mouse |  |  |  |  | male |  | no |  |  |  |  | CRUK Cambridge Institute Genomics Core Facility | ERA809577 |  | public | 0583B304BDB12F341C2740EF1AB241D9 | 6D17774CEEEB0759F7A41DA6F486E7D4
ERR1827132 | 2017-02-21 | 2017-02-24 | 1160433 | 290108250 | 1160433 | 250 | 143 |  | https://sra-download.ncbi.nlm.nih.gov/srapub/ERR1827132 | ERX1889291 | do7552_p | RNA-Seq | cDNA | TRANSCRIPTOMIC | PAIRED | 737 | 479.787 | ILLUMINA | Illumina HiSeq 2500 | ERP016428 | PRJEB14760 |  | 330944 | ERS1549271 | SAMEA83367418 | simple | 10092 | Mus musculus domesticus | western European house mouse |  |  |  |  | male |  | no |  |  |  |  | CRUK Cambridge Institute Genomics Core Facility | ERA809577 |  | public | F0261F8F4CB5E8657EFCD17CEEE59E49 | 2F47E36E7A48E31961B5C131B3AA19C6
ERR1827133 | 2017-02-21 | 2017-02-24 | 2942197 | 735549250 | 2942197 | 250 | 368 |  | https://sra-download.ncbi.nlm.nih.gov/srapub/ERR1827133 | ERX1889292 | do7553_p | RNA-Seq | cDNA | TRANSCRIPTOMIC | PAIRED | 737 | 479.787 | ILLUMINA | Illumina HiSeq 2500 | ERP016428 | PRJEB14760 |  | 330944 | ERS1549272 | SAMEA83368168 | simple | 10092 | Mus musculus domesticus | western European house mouse |  |  |  |  | male |  | no |  |  |  |  | CRUK Cambridge Institute Genomics Core Facility | ERA809577 |  | public | FF64DC7375CC9F7657BC8DE45BE4606E | 17D43C73F77A6619D50B67E3F553E539
ERR1827134 | 2017-02-21 | 2017-02-24 | 2446938 | 611734500 | 2446938 | 250 | 307 |  | https://sra-download.ncbi.nlm.nih.gov/srapub/ERR1827134 | ERX1889293 | do7554_p | RNA-Seq | cDNA | TRANSCRIPTOMIC | PAIRED | 737 | 479.787 | ILLUMINA | Illumina HiSeq 2500 | ERP016428 | PRJEB14760 |  | 330944 | ERS1549273 | SAMEA83368918 | simple | 10092 | Mus musculus domesticus | western European house mouse |  |  |  |  | male |  | no |  |  |  |  | CRUK Cambridge Institute Genomics Core Facility | ERA809577 |  | public | 269ED6455E7D005555D308F4BC3CEA15 | B42462242EC5AF71792BEF36B058B518
ERR1827135 | 2017-02-21 | 2017-02-24 | 2104737 | 526184250 | 2104737 | 250 | 259 |  | https://sra-download.ncbi.nlm.nih.gov/srapub/ERR1827135 | ERX1889294 | do7555_p | RNA-Seq | cDNA | TRANSCRIPTOMIC | PAIRED | 737 | 479.787 | ILLUMINA | Illumina HiSeq 2500 | ERP016428 | PRJEB14760 |  | 330944 | ERS1549274 | SAMEA83369668 | simple | 10092 | Mus musculus domesticus | western European house mouse |  |  |  |  | male |  | no |  |  |  |  | CRUK Cambridge Institute Genomics Core Facility | ERA809577 |  | public | 2A990D15C53CA7C9F35344820AB615EF | 8C6AC2818FF84DE92634F8FF0C89365C
ERR1827136 | 2017-02-21 | 2017-02-24 | 1930547 | 482636750 | 1930547 | 250 | 245 |  | https://sra-download.ncbi.nlm.nih.gov/srapub/ERR1827136 | ERX1889295 | do7556_p | RNA-Seq | cDNA | TRANSCRIPTOMIC | PAIRED | 737 | 479.787 | ILLUMINA | Illumina HiSeq 2500 | ERP016428 | PRJEB14760 |  | 330944 | ERS1549275 | SAMEA83370418 | simple | 10092 | Mus musculus domesticus | western European house mouse |  |  |  |  | male |  | no |  |  |  |  | CRUK Cambridge Institute Genomics Core Facility | ERA809577 |  | public | DCBFF3550FA502E8DB5CB26752E73FA4 | 49846117A09674B81E9E7A7CDA99FE49
ERR1827137 | 2017-02-21 | 2017-02-24 | 3066987 | 766746750 | 3066987 | 250 | 381 |  | https://sra-download.ncbi.nlm.nih.gov/srapub/ERR1827137 | ERX1889296 | do7557_p | RNA-Seq | cDNA | TRANSCRIPTOMIC | PAIRED | 737 | 479.787 | ILLUMINA | Illumina HiSeq 2500 | ERP016428 | PRJEB14760 |  | 330944 | ERS1549276 | SAMEA83371168 | simple | 10092 | Mus musculus domesticus | western European house mouse |  |  |  |  | male |  | no |  |  |  |  | CRUK Cambridge Institute Genomics Core Facility | ERA809577 |  | public | 78652E26B94726997191250C2336F78D | 4470B21438B1D42F90DC5BFAEF902C02
ERR1827138 | 2017-02-21 | 2017-02-24 | 234916 | 58729000 | 234916 | 250 | 29 |  | https://sra-download.ncbi.nlm.nih.gov/srapub/ERR1827138 | ERX1889297 | do7558_p | RNA-Seq | cDNA | TRANSCRIPTOMIC | PAIRED | 737 | 479.787 | ILLUMINA | Illumina HiSeq 2500 | ERP016428 | PRJEB14760 |  | 330944 | ERS1549277 | SAMEA83371918 | simple | 10092 | Mus musculus domesticus | western European house mouse |  |  |  |  | male |  | no |  |  |  |  | CRUK Cambridge Institute Genomics Core Facility | ERA809577 |  | public | A0A02CA2DCEFF7BAFBF5BDB3AD2BC994 | D3F65CF410DA9A73860FD5A3A8BFFFE3
ERR1829923 | 2017-02-22 | 2017-02-24 | 31446352 | 1603763952 | 0 | 51 | 826 |  | https://sra-download.ncbi.nlm.nih.gov/srapub/ERR1829923 | ERX1891899 | Sample 1_s | RNA-Seq | RANDOM PCR | TRANSCRIPTOMIC | SINGLE | 0 | 0 | ILLUMINA | Illumina HiSeq 2500 | ERP021444 | PRJEB19415 |  | 376303 | ERS1555399 | SAMEA87963418 | simple | 10090 | Mus musculus | house mouse |  |  |  |  |  |  | no |  |  |  |  | Sabine Spath, Florian Mair | ERA812826 |  | public | 6EB8C4C42C536D83D9412553D7741977 | 1795A280663E303A520E4D3DD5A6CD2D
ERR1829924 | 2017-02-22 | 2017-02-24 | 30682625 | 1564813875 | 0 | 51 | 801 |  | https://sra-download.ncbi.nlm.nih.gov/srapub/ERR1829924 | ERX1891900 | Sample 10_s | RNA-Seq | RANDOM PCR | TRANSCRIPTOMIC | SINGLE | 0 | 0 | ILLUMINA | Illumina HiSeq 2500 | ERP021444 | PRJEB19415 |  | 376303 | ERS1555400 | SAMEA87964168 | simple | 10090 | Mus musculus | house mouse |  |  |  |  |  |  | no |  |  |  |  | Sabine Spath, Florian Mair | ERA812826 |  | public | 93FF5BD2B3BC7B943EC0C7B16B0992A8 | F2022B1DF4AB0DD964F69AB7DB9E40CB
ERR1829925 | 2017-02-22 | 2017-02-24 | 27442960 | 1399590960 | 0 | 51 | 716 |  | https://sra-download.ncbi.nlm.nih.gov/srapub/ERR1829925 | ERX1891901 | Sample 11_s | RNA-Seq | RANDOM PCR | TRANSCRIPTOMIC | SINGLE | 0 | 0 | ILLUMINA | Illumina HiSeq 2500 | ERP021444 | PRJEB19415 |  | 376303 | ERS1555401 | SAMEA87964918 | simple | 10090 | Mus musculus | house mouse |  |  |  |  |  |  | no |  |  |  |  | Sabine Spath, Florian Mair | ERA812826 |  | public | A6DAF8A7E75AF1E0437B5F01CD9BEF6A | F7BC2E0A279E0D1425D6D537DBCD5BC8
ERR1829926 | 2017-02-22 | 2017-02-24 | 24168602 | 1232598702 | 0 | 51 | 638 |  | https://sra-download.ncbi.nlm.nih.gov/srapub/ERR1829926 | ERX1891902 | Sample 12_s | RNA-Seq | RANDOM PCR | TRANSCRIPTOMIC | SINGLE | 0 | 0 | ILLUMINA | Illumina HiSeq 2500 | ERP021444 | PRJEB19415 |  | 376303 | ERS1555402 | SAMEA87965668 | simple | 10090 | Mus musculus | house mouse |  |  |  |  |  |  | no |  |  |  |  | Sabine Spath, Florian Mair | ERA812826 |  | public | 6F64201E712B213F78ED0EF55D4B90CE | 363F03D95A319085B10A4C97B88118E8
ERR1829927 | 2017-02-22 | 2017-02-24 | 22968350 | 1171385850 | 0 | 51 | 607 |  | https://sra-download.ncbi.nlm.nih.gov/srapub/ERR1829927 | ERX1891903 | Sample 13_s | RNA-Seq | RANDOM PCR | TRANSCRIPTOMIC | SINGLE | 0 | 0 | ILLUMINA | Illumina HiSeq 2500 | ERP021444 | PRJEB19415 |  | 376303 | ERS1555403 | SAMEA87966418 | simple | 10090 | Mus musculus | house mouse |  |  |  |  |  |  | no |  |  |  |  | Sabine Spath, Florian Mair | ERA812826 |  | public | E17D3BF4BB96C67E12912727F3981350 | D95E030D36E0EB84DCE16220C00E5551
ERR1829928 | 2017-02-22 | 2017-02-24 | 34863158 | 1778021058 | 0 | 51 | 912 |  | https://sra-download.ncbi.nlm.nih.gov/srapub/ERR1829928 | ERX1891904 | Sample 14_s | RNA-Seq | RANDOM PCR | TRANSCRIPTOMIC | SINGLE | 0 | 0 | ILLUMINA | Illumina HiSeq 2500 | ERP021444 | PRJEB19415 |  | 376303 | ERS1555404 | SAMEA87967168 | simple | 10090 | Mus musculus | house mouse |  |  |  |  |  |  | no |  |  |  |  | Sabine Spath, Florian Mair | ERA812826 |  | public | 333BC85221EF9FA0F639425A8CC69939 | 6BA1219A3106B537D1B79A2931B3C506
ERR1829929 | 2017-02-22 | 2017-02-24 | 36811791 | 1877401341 | 0 | 51 | 960 |  | https://sra-download.ncbi.nlm.nih.gov/srapub/ERR1829929 | ERX1891905 | Sample 15_s | RNA-Seq | RANDOM PCR | TRANSCRIPTOMIC | SINGLE | 0 | 0 | ILLUMINA | Illumina HiSeq 2500 | ERP021444 | PRJEB19415 |  | 376303 | ERS1555405 | SAMEA87967918 | simple | 10090 | Mus musculus | house mouse |  |  |  |  |  |  | no |  |  |  |  | Sabine Spath, Florian Mair | ERA812826 |  | public | 9CBB718F0B28E70FF9E957963A9572DB | F552F49C7E607AF9FCF3CDA46B53B2ED
ERR1829930 | 2017-02-22 | 2017-02-24 | 25074892 | 1278819492 | 0 | 51 | 659 |  | https://sra-download.ncbi.nlm.nih.gov/srapub/ERR1829930 | ERX1891906 | Sample 2_s | RNA-Seq | RANDOM PCR | TRANSCRIPTOMIC | SINGLE | 0 | 0 | ILLUMINA | Illumina HiSeq 2500 | ERP021444 | PRJEB19415 |  | 376303 | ERS1555406 | SAMEA87968668 | simple | 10090 | Mus musculus | house mouse |  |  |  |  |  |  | no |  |  |  |  | Sabine Spath, Florian Mair | ERA812826 |  | public | 008008959070498B03F5133CB6233755 | B9C4622B204E29855868E17F3A259607
ERR1829931 | 2017-02-22 | 2017-02-24 | 31228821 | 1592669871 | 0 | 51 | 817 |  | https://sra-download.ncbi.nlm.nih.gov/srapub/ERR1829931 | ERX1891907 | Sample 3_s | RNA-Seq | RANDOM PCR | TRANSCRIPTOMIC | SINGLE | 0 | 0 | ILLUMINA | Illumina HiSeq 2500 | ERP021444 | PRJEB19415 |  | 376303 | ERS1555407 | SAMEA87969418 | simple | 10090 | Mus musculus | house mouse |  |  |  |  |  |  | no |  |  |  |  | Sabine Spath, Florian Mair | ERA812826 |  | public | 32DD0B7820901D1C5ECA9DBB49CA965A | B43BA8CC914CB4BDB8A9DA259666003A
ERR1829932 | 2017-02-22 | 2017-02-24 | 29443152 | 1501600752 | 0 | 51 | 763 |  | https://sra-download.ncbi.nlm.nih.gov/srapub/ERR1829932 | ERX1891908 | Sample 4_s | RNA-Seq | RANDOM PCR | TRANSCRIPTOMIC | SINGLE | 0 | 0 | ILLUMINA | Illumina HiSeq 2500 | ERP021444 | PRJEB19415 |  | 376303 | ERS1555408 | SAMEA87970168 | simple | 10090 | Mus musculus | house mouse |  |  |  |  |  |  | no |  |  |  |  | Sabine Spath, Florian Mair | ERA812826 |  | public | E2D77176C545A8BE084F973F1827FCE6 | 86B3FE267E38A09157099AD33A22F877
ERR1829933 | 2017-02-22 | 2017-02-24 | 33227161 | 1694585211 | 0 | 51 | 865 |  | https://sra-download.ncbi.nlm.nih.gov/srapub/ERR1829933 | ERX1891909 | Sample 5_s | RNA-Seq | RANDOM PCR | TRANSCRIPTOMIC | SINGLE | 0 | 0 | ILLUMINA | Illumina HiSeq 2500 | ERP021444 | PRJEB19415 |  | 376303 | ERS1555409 | SAMEA87970918 | simple | 10090 | Mus musculus | house mouse |  |  |  |  |  |  | no |  |  |  |  | Sabine Spath, Florian Mair | ERA812826 |  | public | 4F7C3EE9B01F699F8DC65CBEBBA5CF71 | 77CEE7FC06077CC7F886B8CE68BE017B
ERR1829934 | 2017-02-22 | 2017-02-24 | 33800092 | 1723804692 | 0 | 51 | 877 |  | https://sra-download.ncbi.nlm.nih.gov/srapub/ERR1829934 | ERX1891910 | Sample 6_s | RNA-Seq | RANDOM PCR | TRANSCRIPTOMIC | SINGLE | 0 | 0 | ILLUMINA | Illumina HiSeq 2500 | ERP021444 | PRJEB19415 |  | 376303 | ERS1555410 | SAMEA87971668 | simple | 10090 | Mus musculus | house mouse |  |  |  |  |  |  | no |  |  |  |  | Sabine Spath, Florian Mair | ERA812826 |  | public | 1443C921C2B559F0C050CD5AA04A72F2 | 468DD5227C108A79442E1676809B4CD6
ERR1829935 | 2017-02-22 | 2017-02-24 | 29042806 | 1481183106 | 0 | 51 | 753 |  | https://sra-download.ncbi.nlm.nih.gov/srapub/ERR1829935 | ERX1891911 | Sample 7_s | RNA-Seq | RANDOM PCR | TRANSCRIPTOMIC | SINGLE | 0 | 0 | ILLUMINA | Illumina HiSeq 2500 | ERP021444 | PRJEB19415 |  | 376303 | ERS1555411 | SAMEA87972418 | simple | 10090 | Mus musculus | house mouse |  |  |  |  |  |  | no |  |  |  |  | Sabine Spath, Florian Mair | ERA812826 |  | public | 5A80EA3025E6DC824A7CB04E002EC9A9 | DF73ACA5B4FB58B9716E7C7F546D5D13
ERR1829936 | 2017-02-22 | 2017-02-24 | 35968687 | 1834403037 | 0 | 51 | 933 |  | https://sra-download.ncbi.nlm.nih.gov/srapub/ERR1829936 | ERX1891912 | Sample 8_s | RNA-Seq | RANDOM PCR | TRANSCRIPTOMIC | SINGLE | 0 | 0 | ILLUMINA | Illumina HiSeq 2500 | ERP021444 | PRJEB19415 |  | 376303 | ERS1555412 | SAMEA87973168 | simple | 10090 | Mus musculus | house mouse |  |  |  |  |  |  | no |  |  |  |  | Sabine Spath, Florian Mair | ERA812826 |  | public | CD0BA4EA5D0D3DF73E095CF0807E0ED9 | 761F8881A80182E4D7DE0E37C08AC22B
ERR1829937 | 2017-02-22 | 2017-02-24 | 32895698 | 1677680598 | 0 | 51 | 855 |  | https://sra-download.ncbi.nlm.nih.gov/srapub/ERR1829937 | ERX1891913 | Sample 9_s | RNA-Seq | RANDOM PCR | TRANSCRIPTOMIC | SINGLE | 0 | 0 | ILLUMINA | Illumina HiSeq 2500 | ERP021444 | PRJEB19415 |  | 376303 | ERS1555413 | SAMEA87973918 | simple | 10090 | Mus musculus | house mouse |  |  |  |  |  |  | no |  |  |  |  | Sabine Spath, Florian Mair | ERA812826 |  | public | B33C49157AB63038F0EC902C402AF5DF | 4A4E64633EE5D3434B49A2AC710B514F
SRR5131155 | 2017-02-27 | 2017-01-10 | 21331644 | 5365620090 | 21331644 | 251 | 1918 |  | https://sra-download.ncbi.nlm.nih.gov/srapub/SRR5131155 | SRX2444949 |  | RNA-Seq | PolyA | TRANSCRIPTOMIC | PAIRED | 0 | 0 | ILLUMINA | Illumina HiSeq 2500 | SRP095659 | PRJNA358800 | 2 | 358800 | SRS1878812 | SAMN06185754 | simple | 10090 | Mus musculus | 661w |  |  |  |  | not collected |  | no |  |  |  |  | WENZHOU MEDICAL UNIVERSITY | SRA510172 |  | public | AA03DE581851141DFAC2C518D9D78B14 | 30AA9223DDF1C1952D337675281CE09E
SRR5131263 | 2017-02-27 | 2017-01-13 | 19280746 | 4849971498 | 19280746 | 251 | 1772 |  | https://sra-download.ncbi.nlm.nih.gov/srapub/SRR5131263 | SRX2445086 |  | RNA-Seq | PolyA | TRANSCRIPTOMIC | PAIRED | 0 | 0 | ILLUMINA | Illumina HiSeq 2500 | SRP095666 | PRJNA358805 | 2 | 358805 | SRS1878854 | SAMN06185793 | simple | 10090 | Mus musculus | RP9-KI |  |  |  |  | not collected |  | no |  |  |  |  | WENZHOU MEDICAL UNIVERSITY | SRA510252 |  | public | 243AC4D1F384794CF4673713676B5CE6 | 456833FD0EB52DFD70A9E0CC11960CBD
SRR5131264 | 2017-02-27 | 2017-01-16 | 19417372 | 4883684516 | 19417372 | 251 | 1775 |  | https://sra-download.ncbi.nlm.nih.gov/srapub/SRR5131264 | SRX2445087 |  | RNA-Seq | PolyA | TRANSCRIPTOMIC | PAIRED | 0 | 0 | ILLUMINA | Illumina HiSeq 2500 | SRP095667 | PRJNA358806 | 2 | 358806 | SRS1878855 | SAMN06185794 | simple | 10090 | Mus musculus | RP9-KO |  |  |  |  | not collected |  | no |  |  |  |  | WENZHOU MEDICAL UNIVERSITY | SRA510253 |  | public | 464286C74AE844F1E83DD884F4196C5C | C32183E65C05DA917A172AEB35BE279B
SRR5292111 | 2017-03-02 | 2017-02-27 | 25283392 | 7585017600 | 25283392 | 300 | 3150 |  | https://sra-download.ncbi.nlm.nih.gov/srapub/SRR5292111 | SRX2594754 |  | RNA-Seq | cDNA | TRANSCRIPTOMIC | PAIRED | 0 | 0 | ILLUMINA | Illumina HiSeq 4000 | SRP100778 | PRJNA377098 |  | 377098 | SRS2016326 | SAMN06472507 | simple | 10090 | Mus musculus | GSM2510500 |  |  |  |  |  |  | no |  |  |  |  | GEO | SRA540827 |  | public | 8CDCC498D40229DF7CBC4443DC6E583A | 9AF890215C5E9F2294E63ED97965C124
SRR5292112 | 2017-03-02 | 2017-02-27 | 22198499 | 6659549700 | 22198499 | 300 | 2760 |  | https://sra-download.ncbi.nlm.nih.gov/srapub/SRR5292112 | SRX2594755 |  | RNA-Seq | cDNA | TRANSCRIPTOMIC | PAIRED | 0 | 0 | ILLUMINA | Illumina HiSeq 4000 | SRP100778 | PRJNA377098 |  | 377098 | SRS2016325 | SAMN06472505 | simple | 10090 | Mus musculus | GSM2510501 |  |  |  |  |  |  | no |  |  |  |  | GEO | SRA540827 |  | public | 87479FD08323D8D1F4E29CBD858A97A3 | CDD1C98DB8EDE45068CA165C09CFEB6F
SRR5292113 | 2017-03-02 | 2017-02-27 | 21966137 | 6589841100 | 21966137 | 300 | 2750 |  | https://sra-download.ncbi.nlm.nih.gov/srapub/SRR5292113 | SRX2594756 |  | RNA-Seq | cDNA | TRANSCRIPTOMIC | PAIRED | 0 | 0 | ILLUMINA | Illumina HiSeq 4000 | SRP100778 | PRJNA377098 |  | 377098 | SRS2016327 | SAMN06472503 | simple | 10090 | Mus musculus | GSM2510502 |  |  |  |  |  |  | no |  |  |  |  | GEO | SRA540827 |  | public | E4FAC652CE19DC914639E531578CE10A | 8160D88F48B198B7CCF8C278BBFD1C28
SRR5292114 | 2017-03-02 | 2017-02-27 | 24404624 | 7370196448 | 24404624 | 302 | 3395 |  | https://sra-download.ncbi.nlm.nih.gov/srapub/SRR5292114 | SRX2594757 |  | RNA-Seq | cDNA | TRANSCRIPTOMIC | PAIRED | 0 | 0 | ILLUMINA | Illumina HiSeq 4000 | SRP100778 | PRJNA377098 |  | 377098 | SRS2016328 | SAMN06472502 | simple | 10090 | Mus musculus | GSM2510503 |  |  |  |  |  |  | no |  |  |  |  | GEO | SRA540827 |  | public | 9F3690720FEC3E35571676925ADECA51 | 0DA1A069DB106E68314F24FDF68F8A0F
SRR5292115 | 2017-03-02 | 2017-02-27 | 22144610 | 6643383000 | 22144610 | 300 | 2749 |  | https://sra-download.ncbi.nlm.nih.gov/srapub/SRR5292115 | SRX2594758 |  | RNA-Seq | cDNA | TRANSCRIPTOMIC | PAIRED | 0 | 0 | ILLUMINA | Illumina HiSeq 4000 | SRP100778 | PRJNA377098 |  | 377098 | SRS2016330 | SAMN06472500 | simple | 10090 | Mus musculus | GSM2510504 |  |  |  |  |  |  | no |  |  |  |  | GEO | SRA540827 |  | public | 152AA7DAD8ED4AF6A51254955681D6DE | 88E51C8D9975892E4364E415DFA3BD0B
SRR5292116 | 2017-03-02 | 2017-02-27 | 18679178 | 5603753400 | 18679178 | 300 | 2302 |  | https://sra-download.ncbi.nlm.nih.gov/srapub/SRR5292116 | SRX2594759 |  | RNA-Seq | cDNA | TRANSCRIPTOMIC | PAIRED | 0 | 0 | ILLUMINA | Illumina HiSeq 4000 | SRP100778 | PRJNA377098 |  | 377098 | SRS2016331 | SAMN06472498 | simple | 10090 | Mus musculus | GSM2510505 |  |  |  |  |  |  | no |  |  |  |  | GEO | SRA540827 |  | public | D2E28E8C70FD031FCEC6DBE587A93692 | 907AC06D9F4466AED379E791DC3F6E8E
SRR5292117 | 2017-03-02 | 2017-02-27 | 25112898 | 7584095196 | 25112898 | 302 | 3461 |  | https://sra-download.ncbi.nlm.nih.gov/srapub/SRR5292117 | SRX2594760 |  | RNA-Seq | cDNA | TRANSCRIPTOMIC | PAIRED | 0 | 0 | ILLUMINA | Illumina HiSeq 4000 | SRP100778 | PRJNA377098 |  | 377098 | SRS2016329 | SAMN06472496 | simple | 10090 | Mus musculus | GSM2510506 |  |  |  |  |  |  | no |  |  |  |  | GEO | SRA540827 |  | public | 044215EB7A9229C279738B3CB8218A3E | 1116E5E45696A8533F4AD11EF48E29DB
SRR5292118 | 2017-03-02 | 2017-02-27 | 25024644 | 7557442488 | 25024644 | 302 | 3420 |  | https://sra-download.ncbi.nlm.nih.gov/srapub/SRR5292118 | SRX2594761 |  | RNA-Seq | cDNA | TRANSCRIPTOMIC | PAIRED | 0 | 0 | ILLUMINA | Illumina HiSeq 4000 | SRP100778 | PRJNA377098 |  | 377098 | SRS2016332 | SAMN06472495 | simple | 10090 | Mus musculus | GSM2510507 |  |  |  |  |  |  | no |  |  |  |  | GEO | SRA540827 |  | public | 153017EF8F2CC3B36F5E4E6A287D7FB5 | 153C192393BA6CD45C0E896BD2CF9F5C
SRR5292119 | 2017-03-02 | 2017-02-27 | 25411395 | 7674241290 | 25411395 | 302 | 3517 |  | https://sra-download.ncbi.nlm.nih.gov/srapub/SRR5292119 | SRX2594762 |  | RNA-Seq | cDNA | TRANSCRIPTOMIC | PAIRED | 0 | 0 | ILLUMINA | Illumina HiSeq 4000 | SRP100778 | PRJNA377098 |  | 377098 | SRS2016334 | SAMN06472493 | simple | 10090 | Mus musculus | GSM2510508 |  |  |  |  |  |  | no |  |  |  |  | GEO | SRA540827 |  | public | 627071477B43B9E596DB8AF4DCFEC08D | A98F9C21530CB7368DCC71825AF52888
SRR5292120 | 2017-03-02 | 2017-02-27 | 24673529 | 7451405758 | 24673529 | 302 | 3371 |  | https://sra-download.ncbi.nlm.nih.gov/srapub/SRR5292120 | SRX2594763 |  | RNA-Seq | cDNA | TRANSCRIPTOMIC | PAIRED | 0 | 0 | ILLUMINA | Illumina HiSeq 4000 | SRP100778 | PRJNA377098 |  | 377098 | SRS2016336 | SAMN06472491 | simple | 10090 | Mus musculus | GSM2510509 |  |  |  |  |  |  | no |  |  |  |  | GEO | SRA540827 |  | public | 2168E3DD759162D91BC20AAC887E4697 | C5462B1828532E3E1BE48CF78F60C66C
SRR5292121 | 2017-03-02 | 2017-02-27 | 26409621 | 7975705542 | 26409621 | 302 | 3581 |  | https://sra-download.ncbi.nlm.nih.gov/srapub/SRR5292121 | SRX2594764 |  | RNA-Seq | cDNA | TRANSCRIPTOMIC | PAIRED | 0 | 0 | ILLUMINA | Illumina HiSeq 4000 | SRP100778 | PRJNA377098 |  | 377098 | SRS2016335 | SAMN06472490 | simple | 10090 | Mus musculus | GSM2510510 |  |  |  |  |  |  | no |  |  |  |  | GEO | SRA540827 |  | public | 3FAF5B4ABC47C3293BFAFC7B5A95A3DB | 65BA8A7959E6FEF511D3CDCBC8931F4D
SRR5292122 | 2017-03-02 | 2017-02-27 | 24484470 | 7394309940 | 24484470 | 302 | 3359 |  | https://sra-download.ncbi.nlm.nih.gov/srapub/SRR5292122 | SRX2594765 |  | RNA-Seq | cDNA | TRANSCRIPTOMIC | PAIRED | 0 | 0 | ILLUMINA | Illumina HiSeq 4000 | SRP100778 | PRJNA377098 |  | 377098 | SRS2016333 | SAMN06472488 | simple | 10090 | Mus musculus | GSM2510511 |  |  |  |  |  |  | no |  |  |  |  | GEO | SRA540827 |  | public | CDDCA6D80DFEE22AEDD5832616108AE2 | 0A9E35097D7C14777D2A0C0371F60601
ERR1827008 | 2017-02-21 | 2017-02-24 | 576703 | 144175750 | 576703 | 250 | 82 |  | https://sra-download.ncbi.nlm.nih.gov/srapub/ERR1827008 | ERX1889167 | do7044_p | RNA-Seq | cDNA | TRANSCRIPTOMIC | PAIRED | 682 | 401.016 | ILLUMINA | Illumina HiSeq 2500 | ERP016428 | PRJEB14760 |  | 330944 | ERS1549147 | SAMEA83274418 | simple | 10092 | Mus musculus domesticus | western European house mouse |  |  |  |  | male |  | no |  |  |  |  | CRUK Cambridge Institute Genomics Core Facility | ERA809577 |  | public | BE84F4D0ACC08083C65AD01C1AF11AB8 | 2F852502AE4123ABC1A84F33276C142C
ERR1827009 | 2017-02-21 | 2017-02-24 | 458295 | 114573750 | 458295 | 250 | 65 |  | https://sra-download.ncbi.nlm.nih.gov/srapub/ERR1827009 | ERX1889168 | do7045_p | RNA-Seq | cDNA | TRANSCRIPTOMIC | PAIRED | 682 | 401.016 | ILLUMINA | Illumina HiSeq 2500 | ERP016428 | PRJEB14760 |  | 330944 | ERS1549148 | SAMEA83275168 | simple | 10092 | Mus musculus domesticus | western European house mouse |  |  |  |  | male |  | no |  |  |  |  | CRUK Cambridge Institute Genomics Core Facility | ERA809577 |  | public | 21FCABC26CD676E4C6E726F4BE32E0CB | 6668453EAE12E2D65DC8EB7EAE4AFB21
ERR1827010 | 2017-02-21 | 2017-02-24 | 755998 | 188999500 | 755998 | 250 | 107 |  | https://sra-download.ncbi.nlm.nih.gov/srapub/ERR1827010 | ERX1889169 | do7046_p | RNA-Seq | cDNA | TRANSCRIPTOMIC | PAIRED | 682 | 401.016 | ILLUMINA | Illumina HiSeq 2500 | ERP016428 | PRJEB14760 |  | 330944 | ERS1549149 | SAMEA83275918 | simple | 10092 | Mus musculus domesticus | western European house mouse |  |  |  |  | male |  | no |  |  |  |  | CRUK Cambridge Institute Genomics Core Facility | ERA809577 |  | public | 5D19C558FE8FA2C5DFC047A5200E7AF3 | 1EB4A162F04FA061AF5F84E514D5E142
ERR1827011 | 2017-02-21 | 2017-02-24 | 4693925 | 1173481250 | 4693925 | 250 | 645 |  | https://sra-download.ncbi.nlm.nih.gov/srapub/ERR1827011 | ERX1889170 | do7047_p | RNA-Seq | cDNA | TRANSCRIPTOMIC | PAIRED | 682 | 401.016 | ILLUMINA | Illumina HiSeq 2500 | ERP016428 | PRJEB14760 |  | 330944 | ERS1549150 | SAMEA83276668 | simple | 10092 | Mus musculus domesticus | western European house mouse |  |  |  |  | male |  | no |  |  |  |  | CRUK Cambridge Institute Genomics Core Facility | ERA809577 |  | public | 65561F93CCAB3F841F439C72F118BB9C | AEE77412319300047A943153FB486B81
ERR1827012 | 2017-02-21 | 2017-02-24 | 507942 | 126985500 | 507942 | 250 | 72 |  | https://sra-download.ncbi.nlm.nih.gov/srapub/ERR1827012 | ERX1889171 | do7048_p | RNA-Seq | cDNA | TRANSCRIPTOMIC | PAIRED | 682 | 401.016 | ILLUMINA | Illumina HiSeq 2500 | ERP016428 | PRJEB14760 |  | 330944 | ERS1549151 | SAMEA83277418 | simple | 10092 | Mus musculus domesticus | western European house mouse |  |  |  |  | male |  | no |  |  |  |  | CRUK Cambridge Institute Genomics Core Facility | ERA809577 |  | public | A6E56577504F251E2F43E14789405A03 | CCAFC131F005D8A99F82F56EA72585A0
ERR1827013 | 2017-02-21 | 2017-02-24 | 2464960 | 616240000 | 2464960 | 250 | 351 |  | https://sra-download.ncbi.nlm.nih.gov/srapub/ERR1827013 | ERX1889172 | do7049_p | RNA-Seq | cDNA | TRANSCRIPTOMIC | PAIRED | 682 | 401.016 | ILLUMINA | Illumina HiSeq 2500 | ERP016428 | PRJEB14760 |  | 330944 | ERS1549152 | SAMEA83278168 | simple | 10092 | Mus musculus domesticus | western European house mouse |  |  |  |  | male |  | no |  |  |  |  | CRUK Cambridge Institute Genomics Core Facility | ERA809577 |  | public | 4286EFF667F3DC70731EA04495E42307 | 7D097B2BE898E1D36B40834896A55BAC
ERR1827014 | 2017-02-21 | 2017-02-24 | 1356729 | 339182250 | 1356729 | 250 | 191 |  | https://sra-download.ncbi.nlm.nih.gov/srapub/ERR1827014 | ERX1889173 | do7050_p | RNA-Seq | cDNA | TRANSCRIPTOMIC | PAIRED | 682 | 401.016 | ILLUMINA | Illumina HiSeq 2500 | ERP016428 | PRJEB14760 |  | 330944 | ERS1549153 | SAMEA83278918 | simple | 10092 | Mus musculus domesticus | western European house mouse |  |  |  |  | male |  | no |  |  |  |  | CRUK Cambridge Institute Genomics Core Facility | ERA809577 |  | public | 2EE1C264E35BC264CCD200E7989A89BB | 40EFE4DAF3BF508240C16567068A22DD
ERR1827015 | 2017-02-21 | 2017-02-24 | 2065034 | 516258500 | 2065034 | 250 | 282 |  | https://sra-download.ncbi.nlm.nih.gov/srapub/ERR1827015 | ERX1889174 | do7051_p | RNA-Seq | cDNA | TRANSCRIPTOMIC | PAIRED | 682 | 401.016 | ILLUMINA | Illumina HiSeq 2500 | ERP016428 | PRJEB14760 |  | 330944 | ERS1549154 | SAMEA83279668 | simple | 10092 | Mus musculus domesticus | western European house mouse |  |  |  |  | male |  | no |  |  |  |  | CRUK Cambridge Institute Genomics Core Facility | ERA809577 |  | public | 6FF31AA58515BA819AF4CEA206A4AAFC | 449B55081E5ACAFB707C02C0CE7D4A60
ERR1827016 | 2017-02-21 | 2017-02-24 | 1672828 | 418207000 | 1672828 | 250 | 241 |  | https://sra-download.ncbi.nlm.nih.gov/srapub/ERR1827016 | ERX1889175 | do7052_p | RNA-Seq | cDNA | TRANSCRIPTOMIC | PAIRED | 682 | 401.016 | ILLUMINA | Illumina HiSeq 2500 | ERP016428 | PRJEB14760 |  | 330944 | ERS1549155 | SAMEA83280418 | simple | 10092 | Mus musculus domesticus | western European house mouse |  |  |  |  | male |  | no |  |  |  |  | CRUK Cambridge Institute Genomics Core Facility | ERA809577 |  | public | D3147045969EAEAC065BE438C80982C1 | FE6DB3E641C2A2C97BFE0DB59C5010F2
ERR1827017 | 2017-02-21 | 2017-02-24 | 1442332 | 360583000 | 1442332 | 250 | 199 |  | https://sra-download.ncbi.nlm.nih.gov/srapub/ERR1827017 | ERX1889176 | do7053_p | RNA-Seq | cDNA | TRANSCRIPTOMIC | PAIRED | 682 | 401.016 | ILLUMINA | Illumina HiSeq 2500 | ERP016428 | PRJEB14760 |  | 330944 | ERS1549156 | SAMEA83281168 | simple | 10092 | Mus musculus domesticus | western European house mouse |  |  |  |  | male |  | no |  |  |  |  | CRUK Cambridge Institute Genomics Core Facility | ERA809577 |  | public | 1CC559F548042C0935705288996E13F9 | 55E7C5941F70AF20241B26541BD8C2C6
ERR1827018 | 2017-02-21 | 2017-02-24 | 2087861 | 521965250 | 2087861 | 250 | 297 |  | https://sra-download.ncbi.nlm.nih.gov/srapub/ERR1827018 | ERX1889177 | do7054_p | RNA-Seq | cDNA | TRANSCRIPTOMIC | PAIRED | 682 | 401.016 | ILLUMINA | Illumina HiSeq 2500 | ERP016428 | PRJEB14760 |  | 330944 | ERS1549157 | SAMEA83281918 | simple | 10092 | Mus musculus domesticus | western European house mouse |  |  |  |  | male |  | no |  |  |  |  | CRUK Cambridge Institute Genomics Core Facility | ERA809577 |  | public | B97ED5ED08D62A5F9C10B962C95C5595 | 5979AEEAAD315AF4843DD0C286D9557E
ERR1827019 | 2017-02-21 | 2017-02-24 | 1138657 | 284664250 | 1138657 | 250 | 161 |  | https://sra-download.ncbi.nlm.nih.gov/srapub/ERR1827019 | ERX1889178 | do7055_p | RNA-Seq | cDNA | TRANSCRIPTOMIC | PAIRED | 682 | 401.016 | ILLUMINA | Illumina HiSeq 2500 | ERP016428 | PRJEB14760 |  | 330944 | ERS1549158 | SAMEA83282668 | simple | 10092 | Mus musculus domesticus | western European house mouse |  |  |  |  | male |  | no |  |  |  |  | CRUK Cambridge Institute Genomics Core Facility | ERA809577 |  | public | 3A2611E389A568EB1A31B179DD0DC418 | 448306E0DA8CF472D21B5344BDB8F168
ERR1827020 | 2017-02-21 | 2017-02-24 | 2020052 | 505013000 | 2020052 | 250 | 289 |  | https://sra-download.ncbi.nlm.nih.gov/srapub/ERR1827020 | ERX1889179 | do7056_p | RNA-Seq | cDNA | TRANSCRIPTOMIC | PAIRED | 682 | 401.016 | ILLUMINA | Illumina HiSeq 2500 | ERP016428 | PRJEB14760 |  | 330944 | ERS1549159 | SAMEA83283418 | simple | 10092 | Mus musculus domesticus | western European house mouse |  |  |  |  | male |  | no |  |  |  |  | CRUK Cambridge Institute Genomics Core Facility | ERA809577 |  | public | 2563CA825CAB902BB1D84E7507FDA9C2 | DDA5005BC0C58C913D3D2E23AEBC5FBF
ERR1827021 | 2017-02-21 | 2017-02-24 | 745631 | 186407750 | 745631 | 250 | 104 |  | https://sra-download.ncbi.nlm.nih.gov/srapub/ERR1827021 | ERX1889180 | do7057_p | RNA-Seq | cDNA | TRANSCRIPTOMIC | PAIRED | 682 | 401.016 | ILLUMINA | Illumina HiSeq 2500 | ERP016428 | PRJEB14760 |  | 330944 | ERS1549160 | SAMEA83284168 | simple | 10092 | Mus musculus domesticus | western European house mouse |  |  |  |  | male |  | no |  |  |  |  | CRUK Cambridge Institute Genomics Core Facility | ERA809577 |  | public | BBB5AEECBAEBB1099ACEB04061494D20 | 11712DE33C9EFA9ABB333F06B1F8558E
ERR1827022 | 2017-02-21 | 2017-02-24 | 1707154 | 426788500 | 1707154 | 250 | 249 |  | https://sra-download.ncbi.nlm.nih.gov/srapub/ERR1827022 | ERX1889181 | do7058_p | RNA-Seq | cDNA | TRANSCRIPTOMIC | PAIRED | 682 | 401.016 | ILLUMINA | Illumina HiSeq 2500 | ERP016428 | PRJEB14760 |  | 330944 | ERS1549161 | SAMEA83284918 | simple | 10092 | Mus musculus domesticus | western European house mouse |  |  |  |  | male |  | no |  |  |  |  | CRUK Cambridge Institute Genomics Core Facility | ERA809577 |  | public | 824E16A7E5A5270C22A40A9CB7C6EC61 | A617B7B96EB3BA250AED549A1F8A46E2
ERR1827023 | 2017-02-21 | 2017-02-24 | 425687 | 106421750 | 425687 | 250 | 60 |  | https://sra-download.ncbi.nlm.nih.gov/srapub/ERR1827023 | ERX1889182 | do7059_p | RNA-Seq | cDNA | TRANSCRIPTOMIC | PAIRED | 682 | 401.016 | ILLUMINA | Illumina HiSeq 2500 | ERP016428 | PRJEB14760 |  | 330944 | ERS1549162 | SAMEA83285668 | simple | 10092 | Mus musculus domesticus | western European house mouse |  |  |  |  | male |  | no |  |  |  |  | CRUK Cambridge Institute Genomics Core Facility | ERA809577 |  | public | 8D099775F705174158FCE1A458825D6C | 28AE1D441A50D7AA97E30482B9958CC8
ERR1827024 | 2017-02-21 | 2017-02-24 | 1954192 | 488548000 | 1954192 | 250 | 277 |  | https://sra-download.ncbi.nlm.nih.gov/srapub/ERR1827024 | ERX1889183 | do7060_p | RNA-Seq | cDNA | TRANSCRIPTOMIC | PAIRED | 682 | 401.016 | ILLUMINA | Illumina HiSeq 2500 | ERP016428 | PRJEB14760 |  | 330944 | ERS1549163 | SAMEA83286418 | simple | 10092 | Mus musculus domesticus | western European house mouse |  |  |  |  | male |  | no |  |  |  |  | CRUK Cambridge Institute Genomics Core Facility | ERA809577 |  | public | A60CB540C8381D82728AD8358A943CF0 | F2FE810FB4E44C7B88356F03F11C701E
ERR1827025 | 2017-02-21 | 2017-02-24 | 297854 | 74463500 | 297854 | 250 | 42 |  | https://sra-download.ncbi.nlm.nih.gov/srapub/ERR1827025 | ERX1889184 | do7061_p | RNA-Seq | cDNA | TRANSCRIPTOMIC | PAIRED | 682 | 401.016 | ILLUMINA | Illumina HiSeq 2500 | ERP016428 | PRJEB14760 |  | 330944 | ERS1549164 | SAMEA83287168 | simple | 10092 | Mus musculus domesticus | western European house mouse |  |  |  |  | male |  | no |  |  |  |  | CRUK Cambridge Institute Genomics Core Facility | ERA809577 |  | public | AA10744302E33D4960FBB2248AC266B4 | 2C9163D18966F8C17F14237A2573504B
ERR1827026 | 2017-02-21 | 2017-02-24 | 3230014 | 807503500 | 3230014 | 250 | 455 |  | https://sra-download.ncbi.nlm.nih.gov/srapub/ERR1827026 | ERX1889185 | do7062_p | RNA-Seq | cDNA | TRANSCRIPTOMIC | PAIRED | 682 | 401.016 | ILLUMINA | Illumina HiSeq 2500 | ERP016428 | PRJEB14760 |  | 330944 | ERS1549165 | SAMEA83287918 | simple | 10092 | Mus musculus domesticus | western European house mouse |  |  |  |  | male |  | no |  |  |  |  | CRUK Cambridge Institute Genomics Core Facility | ERA809577 |  | public | DB3DFA4514BD86C6AC83A47B25C90D01 | 160489C86AA86BD8520D18CCC56B6E4D
ERR1827027 | 2017-02-21 | 2017-02-24 | 2330809 | 582702250 | 2330809 | 250 | 320 |  | https://sra-download.ncbi.nlm.nih.gov/srapub/ERR1827027 | ERX1889186 | do7063_p | RNA-Seq | cDNA | TRANSCRIPTOMIC | PAIRED | 682 | 401.016 | ILLUMINA | Illumina HiSeq 2500 | ERP016428 | PRJEB14760 |  | 330944 | ERS1549166 | SAMEA83288668 | simple | 10092 | Mus musculus domesticus | western European house mouse |  |  |  |  | male |  | no |  |  |  |  | CRUK Cambridge Institute Genomics Core Facility | ERA809577 |  | public | 9B93FDBA33B9E060169FE9A3B45B69E2 | 9911DFC7491DABE35082275C27379FE1
ERR1827028 | 2017-02-21 | 2017-02-24 | 773931 | 193482750 | 773931 | 250 | 110 |  | https://sra-download.ncbi.nlm.nih.gov/srapub/ERR1827028 | ERX1889187 | do7064_p | RNA-Seq | cDNA | TRANSCRIPTOMIC | PAIRED | 682 | 401.016 | ILLUMINA | Illumina HiSeq 2500 | ERP016428 | PRJEB14760 |  | 330944 | ERS1549167 | SAMEA83289418 | simple | 10092 | Mus musculus domesticus | western European house mouse |  |  |  |  | male |  | no |  |  |  |  | CRUK Cambridge Institute Genomics Core Facility | ERA809577 |  | public | 8EAECA03E2AFB1B69E59CF08FF3250F9 | 8A869C4EC6A627709559930087A118D5
ERR1827029 | 2017-02-21 | 2017-02-24 | 920435 | 230108750 | 920435 | 250 | 128 |  | https://sra-download.ncbi.nlm.nih.gov/srapub/ERR1827029 | ERX1889188 | do7065_p | RNA-Seq | cDNA | TRANSCRIPTOMIC | PAIRED | 682 | 401.016 | ILLUMINA | Illumina HiSeq 2500 | ERP016428 | PRJEB14760 |  | 330944 | ERS1549168 | SAMEA83290168 | simple | 10092 | Mus musculus domesticus | western European house mouse |  |  |  |  | male |  | no |  |  |  |  | CRUK Cambridge Institute Genomics Core Facility | ERA809577 |  | public | D97A4EF68DB06AF3CB12CDF3FE512C50 | 97F565CB4B1E6DB557DD381C7A20B84C
ERR1827030 | 2017-02-21 | 2017-02-24 | 2323298 | 580824500 | 2323298 | 250 | 327 |  | https://sra-download.ncbi.nlm.nih.gov/srapub/ERR1827030 | ERX1889189 | do7066_p | RNA-Seq | cDNA | TRANSCRIPTOMIC | PAIRED | 682 | 401.016 | ILLUMINA | Illumina HiSeq 2500 | ERP016428 | PRJEB14760 |  | 330944 | ERS1549169 | SAMEA83290918 | simple | 10092 | Mus musculus domesticus | western European house mouse |  |  |  |  | male |  | no |  |  |  |  | CRUK Cambridge Institute Genomics Core Facility | ERA809577 |  | public | 009DAB9FA7D30B4C5CC0B9CD649492B4 | 612DCE5FD3B133F60D335F04D0618253
ERR1827031 | 2017-02-21 | 2017-02-24 | 2325891 | 581472750 | 2325891 | 250 | 330 |  | https://sra-download.ncbi.nlm.nih.gov/srapub/ERR1827031 | ERX1889190 | do7067_p | RNA-Seq | cDNA | TRANSCRIPTOMIC | PAIRED | 682 | 401.016 | ILLUMINA | Illumina HiSeq 2500 | ERP016428 | PRJEB14760 |  | 330944 | ERS1549170 | SAMEA83291668 | simple | 10092 | Mus musculus domesticus | western European house mouse |  |  |  |  | male |  | no |  |  |  |  | CRUK Cambridge Institute Genomics Core Facility | ERA809577 |  | public | B6FAE7F5087C601F06C5324F7E3C2454 | D7E738059623014D78D44D85878F62FF
ERR1827032 | 2017-02-21 | 2017-02-24 | 2269221 | 567305250 | 2269221 | 250 | 324 |  | https://sra-download.ncbi.nlm.nih.gov/srapub/ERR1827032 | ERX1889191 | do7068_p | RNA-Seq | cDNA | TRANSCRIPTOMIC | PAIRED | 682 | 401.016 | ILLUMINA | Illumina HiSeq 2500 | ERP016428 | PRJEB14760 |  | 330944 | ERS1549171 | SAMEA83292418 | simple | 10092 | Mus musculus domesticus | western European house mouse |  |  |  |  | male |  | no |  |  |  |  | CRUK Cambridge Institute Genomics Core Facility | ERA809577 |  | public | BBCCE4181CA3E67F3E731AFBEBB917BD | 6D432DFDA25481664C4155F99072D915
ERR1827033 | 2017-02-21 | 2017-02-24 | 410529 | 102632250 | 410529 | 250 | 58 |  | https://sra-download.ncbi.nlm.nih.gov/srapub/ERR1827033 | ERX1889192 | do7069_p | RNA-Seq | cDNA | TRANSCRIPTOMIC | PAIRED | 682 | 401.016 | ILLUMINA | Illumina HiSeq 2500 | ERP016428 | PRJEB14760 |  | 330944 | ERS1549172 | SAMEA83293168 | simple | 10092 | Mus musculus domesticus | western European house mouse |  |  |  |  | male |  | no |  |  |  |  | CRUK Cambridge Institute Genomics Core Facility | ERA809577 |  | public | 66EF2C1EE24BA96F84EB48D60EAA2276 | BE89CD0144F84369F947E72117095BF4
ERR1827034 | 2017-02-21 | 2017-02-24 | 2857755 | 714438750 | 2857755 | 250 | 405 |  | https://sra-download.ncbi.nlm.nih.gov/srapub/ERR1827034 | ERX1889193 | do7070_p | RNA-Seq | cDNA | TRANSCRIPTOMIC | PAIRED | 682 | 401.016 | ILLUMINA | Illumina HiSeq 2500 | ERP016428 | PRJEB14760 |  | 330944 | ERS1549173 | SAMEA83293918 | simple | 10092 | Mus musculus domesticus | western European house mouse |  |  |  |  | male |  | no |  |  |  |  | CRUK Cambridge Institute Genomics Core Facility | ERA809577 |  | public | 7236D55B2F1CD86E408F7CD9C21A2176 | F22CC114EA7DDF46E6B9785D326FADB4
ERR1827035 | 2017-02-21 | 2017-02-24 | 2480399 | 620099750 | 2480399 | 250 | 347 |  | https://sra-download.ncbi.nlm.nih.gov/srapub/ERR1827035 | ERX1889194 | do7071_p | RNA-Seq | cDNA | TRANSCRIPTOMIC | PAIRED | 682 | 401.016 | ILLUMINA | Illumina HiSeq 2500 | ERP016428 | PRJEB14760 |  | 330944 | ERS1549174 | SAMEA83294668 | simple | 10092 | Mus musculus domesticus | western European house mouse |  |  |  |  | male |  | no |  |  |  |  | CRUK Cambridge Institute Genomics Core Facility | ERA809577 |  | public | F2A6B27F41886F0CDB01563C954F6850 | 43FDF231D4C30A976949D8EF64F468A7
ERR1827036 | 2017-02-21 | 2017-02-24 | 2877402 | 719350500 | 2877402 | 250 | 407 |  | https://sra-download.ncbi.nlm.nih.gov/srapub/ERR1827036 | ERX1889195 | do7072_p | RNA-Seq | cDNA | TRANSCRIPTOMIC | PAIRED | 682 | 401.016 | ILLUMINA | Illumina HiSeq 2500 | ERP016428 | PRJEB14760 |  | 330944 | ERS1549175 | SAMEA83295418 | simple | 10092 | Mus musculus domesticus | western European house mouse |  |  |  |  | male |  | no |  |  |  |  | CRUK Cambridge Institute Genomics Core Facility | ERA809577 |  | public | B01CCF63B87BC85FD6C43FD5DDD9389F | AFA0AE199608E1FE08589D99A58CC6CA
ERR1827037 | 2017-02-21 | 2017-02-24 | 2313283 | 578320750 | 2313283 | 250 | 329 |  | https://sra-download.ncbi.nlm.nih.gov/srapub/ERR1827037 | ERX1889196 | do7073_p | RNA-Seq | cDNA | TRANSCRIPTOMIC | PAIRED | 682 | 401.016 | ILLUMINA | Illumina HiSeq 2500 | ERP016428 | PRJEB14760 |  | 330944 | ERS1549176 | SAMEA83296168 | simple | 10092 | Mus musculus domesticus | western European house mouse |  |  |  |  | male |  | no |  |  |  |  | CRUK Cambridge Institute Genomics Core Facility | ERA809577 |  | public | 723C5CEEA828CA6010602342FB48B936 | 2E019EA84C10AEB36C27B322A44657B8
ERR1827038 | 2017-02-21 | 2017-02-24 | 2533009 | 633252250 | 2533009 | 250 | 361 |  | https://sra-download.ncbi.nlm.nih.gov/srapub/ERR1827038 | ERX1889197 | do7074_p | RNA-Seq | cDNA | TRANSCRIPTOMIC | PAIRED | 682 | 401.016 | ILLUMINA | Illumina HiSeq 2500 | ERP016428 | PRJEB14760 |  | 330944 | ERS1549177 | SAMEA83296918 | simple | 10092 | Mus musculus domesticus | western European house mouse |  |  |  |  | male |  | no |  |  |  |  | CRUK Cambridge Institute Genomics Core Facility | ERA809577 |  | public | 08D2838C59069EBB8353DDA266EDD9B6 | D46A80A84545B4A31A11C578505BBEE4
ERR1827039 | 2017-02-21 | 2017-02-24 | 1526254 | 381563500 | 1526254 | 250 | 208 |  | https://sra-download.ncbi.nlm.nih.gov/srapub/ERR1827039 | ERX1889198 | do7075_p | RNA-Seq | cDNA | TRANSCRIPTOMIC | PAIRED | 682 | 401.016 | ILLUMINA | Illumina HiSeq 2500 | ERP016428 | PRJEB14760 |  | 330944 | ERS1549178 | SAMEA83297668 | simple | 10092 | Mus musculus domesticus | western European house mouse |  |  |  |  | male |  | no |  |  |  |  | CRUK Cambridge Institute Genomics Core Facility | ERA809577 |  | public | 1BF0E127643657FDED8037FD3956D70E | D6887A89766A19222F5DD12AF2BB39A8
ERR1827040 | 2017-02-21 | 2017-02-24 | 2134953 | 533738250 | 2134953 | 250 | 305 |  | https://sra-download.ncbi.nlm.nih.gov/srapub/ERR1827040 | ERX1889199 | do7076_p | RNA-Seq | cDNA | TRANSCRIPTOMIC | PAIRED | 682 | 401.016 | ILLUMINA | Illumina HiSeq 2500 | ERP016428 | PRJEB14760 |  | 330944 | ERS1549179 | SAMEA83298418 | simple | 10092 | Mus musculus domesticus | western European house mouse |  |  |  |  | male |  | no |  |  |  |  | CRUK Cambridge Institute Genomics Core Facility | ERA809577 |  | public | 2C537ADE71C89D0F791D4CF926B49A4B | 39BAE06FFA5665F429367E1F150CE6A2
ERR1827041 | 2017-02-21 | 2017-02-24 | 2160531 | 540132750 | 2160531 | 250 | 304 |  | https://sra-download.ncbi.nlm.nih.gov/srapub/ERR1827041 | ERX1889200 | do7077_p | RNA-Seq | cDNA | TRANSCRIPTOMIC | PAIRED | 682 | 401.016 | ILLUMINA | Illumina HiSeq 2500 | ERP016428 | PRJEB14760 |  | 330944 | ERS1549180 | SAMEA83299168 | simple | 10092 | Mus musculus domesticus | western European house mouse |  |  |  |  | male |  | no |  |  |  |  | CRUK Cambridge Institute Genomics Core Facility | ERA809577 |  | public | F8DD3BB3984D5E2CA2B93F2DF8A70545 | 354949DF9322A71CCE6FEE568B76CAC0
ERR1827042 | 2017-02-21 | 2017-02-24 | 2801489 | 700372250 | 2801489 | 250 | 393 |  | https://sra-download.ncbi.nlm.nih.gov/srapub/ERR1827042 | ERX1889201 | do7078_p | RNA-Seq | cDNA | TRANSCRIPTOMIC | PAIRED | 682 | 401.016 | ILLUMINA | Illumina HiSeq 2500 | ERP016428 | PRJEB14760 |  | 330944 | ERS1549181 | SAMEA83299918 | simple | 10092 | Mus musculus domesticus | western European house mouse |  |  |  |  | male |  | no |  |  |  |  | CRUK Cambridge Institute Genomics Core Facility | ERA809577 |  | public | 0425F304E307120EC1F5E9CED0D969B4 | 16811E7E25921FA41C940770C0DBF15C
ERR1827043 | 2017-02-21 | 2017-02-24 | 190074 | 47518500 | 190074 | 250 | 24 |  | https://sra-download.ncbi.nlm.nih.gov/srapub/ERR1827043 | ERX1889202 | do7463_p | RNA-Seq | cDNA | TRANSCRIPTOMIC | PAIRED | 737 | 479.787 | ILLUMINA | Illumina HiSeq 2500 | ERP016428 | PRJEB14760 |  | 330944 | ERS1549182 | SAMEA83300668 | simple | 10092 | Mus musculus domesticus | western European house mouse |  |  |  |  | male |  | no |  |  |  |  | CRUK Cambridge Institute Genomics Core Facility | ERA809577 |  | public | 052F3C266AA837E3CF09B05C5738F8F8 | 497C6DFB2A23EE2707FE0BDC73AF391E
ERR1827044 | 2017-02-21 | 2017-02-24 | 3064201 | 766050250 | 3064201 | 250 | 389 |  | https://sra-download.ncbi.nlm.nih.gov/srapub/ERR1827044 | ERX1889203 | do7464_p | RNA-Seq | cDNA | TRANSCRIPTOMIC | PAIRED | 737 | 479.787 | ILLUMINA | Illumina HiSeq 2500 | ERP016428 | PRJEB14760 |  | 330944 | ERS1549183 | SAMEA83301418 | simple | 10092 | Mus musculus domesticus | western European house mouse |  |  |  |  | male |  | no |  |  |  |  | CRUK Cambridge Institute Genomics Core Facility | ERA809577 |  | public | 237E2A2F1EAF4CBEB0E84F20FD7C03FD | 0D65C90CBFAF6BFE2B0D5797F8F8893C
ERR1827045 | 2017-02-21 | 2017-02-24 | 149804 | 37451000 | 149804 | 250 | 19 |  | https://sra-download.ncbi.nlm.nih.gov/srapub/ERR1827045 | ERX1889204 | do7465_p | RNA-Seq | cDNA | TRANSCRIPTOMIC | PAIRED | 737 | 479.787 | ILLUMINA | Illumina HiSeq 2500 | ERP016428 | PRJEB14760 |  | 330944 | ERS1549184 | SAMEA83302168 | simple | 10092 | Mus musculus domesticus | western European house mouse |  |  |  |  | male |  | no |  |  |  |  | CRUK Cambridge Institute Genomics Core Facility | ERA809577 |  | public | E9A6783F41A641F7F300ED3662EF5214 | 2EB0C76FCE9934FF33D265655F626F32
ERR1827046 | 2017-02-21 | 2017-02-24 | 2593618 | 648404500 | 2593618 | 250 | 333 |  | https://sra-download.ncbi.nlm.nih.gov/srapub/ERR1827046 | ERX1889205 | do7466_p | RNA-Seq | cDNA | TRANSCRIPTOMIC | PAIRED | 737 | 479.787 | ILLUMINA | Illumina HiSeq 2500 | ERP016428 | PRJEB14760 |  | 330944 | ERS1549185 | SAMEA83302918 | simple | 10092 | Mus musculus domesticus | western European house mouse |  |  |  |  | male |  | no |  |  |  |  | CRUK Cambridge Institute Genomics Core Facility | ERA809577 |  | public | 2B56A4045DB34B57241D0AC16EE35130 | 79FF160B5B029A3E5EAD14019AEBE8F3
ERR1827047 | 2017-02-21 | 2017-02-24 | 3436674 | 859168500 | 3436674 | 250 | 425 |  | https://sra-download.ncbi.nlm.nih.gov/srapub/ERR1827047 | ERX1889206 | do7467_p | RNA-Seq | cDNA | TRANSCRIPTOMIC | PAIRED | 737 | 479.787 | ILLUMINA | Illumina HiSeq 2500 | ERP016428 | PRJEB14760 |  | 330944 | ERS1549186 | SAMEA83303668 | simple | 10092 | Mus musculus domesticus | western European house mouse |  |  |  |  | male |  | no |  |  |  |  | CRUK Cambridge Institute Genomics Core Facility | ERA809577 |  | public | 917C338B8B8693AE7B8EC98029B4F513 | 3A68293FA8BECD633462AF634FDB3C2D
ERR1827048 | 2017-02-21 | 2017-02-24 | 231371 | 57842750 | 231371 | 250 | 29 |  | https://sra-download.ncbi.nlm.nih.gov/srapub/ERR1827048 | ERX1889207 | do7468_p | RNA-Seq | cDNA | TRANSCRIPTOMIC | PAIRED | 737 | 479.787 | ILLUMINA | Illumina HiSeq 2500 | ERP016428 | PRJEB14760 |  | 330944 | ERS1549187 | SAMEA83304418 | simple | 10092 | Mus musculus domesticus | western European house mouse |  |  |  |  | male |  | no |  |  |  |  | CRUK Cambridge Institute Genomics Core Facility | ERA809577 |  | public | 812B1859765A8FF6A4CFB9474BC0886A | 662803340E88306FC7B4C83D9AE69427
ERR1827049 | 2017-02-21 | 2017-02-24 | 3403956 | 850989000 | 3403956 | 250 | 427 |  | https://sra-download.ncbi.nlm.nih.gov/srapub/ERR1827049 | ERX1889208 | do7469_p | RNA-Seq | cDNA | TRANSCRIPTOMIC | PAIRED | 737 | 479.787 | ILLUMINA | Illumina HiSeq 2500 | ERP016428 | PRJEB14760 |  | 330944 | ERS1549188 | SAMEA83305168 | simple | 10092 | Mus musculus domesticus | western European house mouse |  |  |  |  | male |  | no |  |  |  |  | CRUK Cambridge Institute Genomics Core Facility | ERA809577 |  | public | 8C9DEA6A4C1CCF213BBB2783FF1C8671 | 2604B091E818F662825F318F1750B232
ERR1827050 | 2017-02-21 | 2017-02-24 | 3185785 | 796446250 | 3185785 | 250 | 410 |  | https://sra-download.ncbi.nlm.nih.gov/srapub/ERR1827050 | ERX1889209 | do7470_p | RNA-Seq | cDNA | TRANSCRIPTOMIC | PAIRED | 737 | 479.787 | ILLUMINA | Illumina HiSeq 2500 | ERP016428 | PRJEB14760 |  | 330944 | ERS1549189 | SAMEA83305918 | simple | 10092 | Mus musculus domesticus | western European house mouse |  |  |  |  | male |  | no |  |  |  |  | CRUK Cambridge Institute Genomics Core Facility | ERA809577 |  | public | E21F21941489232EC9FA00EE3CC3B7DB | 38527A18B37E9F5018834E9CBD1D931B
ERR1827051 | 2017-02-21 | 2017-02-24 | 2200237 | 550059250 | 2200237 | 250 | 274 |  | https://sra-download.ncbi.nlm.nih.gov/srapub/ERR1827051 | ERX1889210 | do7471_p | RNA-Seq | cDNA | TRANSCRIPTOMIC | PAIRED | 737 | 479.787 | ILLUMINA | Illumina HiSeq 2500 | ERP016428 | PRJEB14760 |  | 330944 | ERS1549190 | SAMEA83306668 | simple | 10092 | Mus musculus domesticus | western European house mouse |  |  |  |  | male |  | no |  |  |  |  | CRUK Cambridge Institute Genomics Core Facility | ERA809577 |  | public | 83AE1C8DC056C74345184E09C094AF1E | 8C1907B5F520594A21DD687C9F2D8166
ERR1827052 | 2017-02-21 | 2017-02-24 | 1382753 | 345688250 | 1382753 | 250 | 175 |  | https://sra-download.ncbi.nlm.nih.gov/srapub/ERR1827052 | ERX1889211 | do7472_p | RNA-Seq | cDNA | TRANSCRIPTOMIC | PAIRED | 737 | 479.787 | ILLUMINA | Illumina HiSeq 2500 | ERP016428 | PRJEB14760 |  | 330944 | ERS1549191 | SAMEA83307418 | simple | 10092 | Mus musculus domesticus | western European house mouse |  |  |  |  | male |  | no |  |  |  |  | CRUK Cambridge Institute Genomics Core Facility | ERA809577 |  | public | B3FC48C4B9583E6A71B156366BCDFBEF | B6AD467CF8C9BF0D7895011DD2EB2CE7
ERR1827053 | 2017-02-21 | 2017-02-24 | 237952 | 59488000 | 237952 | 250 | 30 |  | https://sra-download.ncbi.nlm.nih.gov/srapub/ERR1827053 | ERX1889212 | do7473_p | RNA-Seq | cDNA | TRANSCRIPTOMIC | PAIRED | 737 | 479.787 | ILLUMINA | Illumina HiSeq 2500 | ERP016428 | PRJEB14760 |  | 330944 | ERS1549192 | SAMEA83308168 | simple | 10092 | Mus musculus domesticus | western European house mouse |  |  |  |  | male |  | no |  |  |  |  | CRUK Cambridge Institute Genomics Core Facility | ERA809577 |  | public | 03BE7CF5EE6A7F801D7738F603D688FD | 8D95391DBDE42F3D84EB67E75C656DDF
ERR1827054 | 2017-02-21 | 2017-02-24 | 2677915 | 669478750 | 2677915 | 250 | 338 |  | https://sra-download.ncbi.nlm.nih.gov/srapub/ERR1827054 | ERX1889213 | do7474_p | RNA-Seq | cDNA | TRANSCRIPTOMIC | PAIRED | 737 | 479.787 | ILLUMINA | Illumina HiSeq 2500 | ERP016428 | PRJEB14760 |  | 330944 | ERS1549193 | SAMEA83308918 | simple | 10092 | Mus musculus domesticus | western European house mouse |  |  |  |  | male |  | no |  |  |  |  | CRUK Cambridge Institute Genomics Core Facility | ERA809577 |  | public | 915241DD0F37EAC88CEC2E6873F7D8EF | B9CF97115CBA46AA76067B18C8C7EDFC
ERR1827055 | 2017-02-21 | 2017-02-24 | 2927602 | 731900500 | 2927602 | 250 | 363 |  | https://sra-download.ncbi.nlm.nih.gov/srapub/ERR1827055 | ERX1889214 | do7475_p | RNA-Seq | cDNA | TRANSCRIPTOMIC | PAIRED | 737 | 479.787 | ILLUMINA | Illumina HiSeq 2500 | ERP016428 | PRJEB14760 |  | 330944 | ERS1549194 | SAMEA83309668 | simple | 10092 | Mus musculus domesticus | western European house mouse |  |  |  |  | male |  | no |  |  |  |  | CRUK Cambridge Institute Genomics Core Facility | ERA809577 |  | public | C28DF339203FEF5EF6857C81B03BF172 | CFEBAC70AC059D8C3BD3E3A6C485B007
ERR1827056 | 2017-02-21 | 2017-02-24 | 3214979 | 803744750 | 3214979 | 250 | 397 |  | https://sra-download.ncbi.nlm.nih.gov/srapub/ERR1827056 | ERX1889215 | do7476_p | RNA-Seq | cDNA | TRANSCRIPTOMIC | PAIRED | 737 | 479.787 | ILLUMINA | Illumina HiSeq 2500 | ERP016428 | PRJEB14760 |  | 330944 | ERS1549195 | SAMEA83310418 | simple | 10092 | Mus musculus domesticus | western European house mouse |  |  |  |  | male |  | no |  |  |  |  | CRUK Cambridge Institute Genomics Core Facility | ERA809577 |  | public | 28FB53C9ED0C287B606CB6FCAA3D57D0 | EA447465ED3BE9648090AA97F8CFB2CE
ERR1827057 | 2017-02-21 | 2017-02-24 | 3249733 | 812433250 | 3249733 | 250 | 398 |  | https://sra-download.ncbi.nlm.nih.gov/srapub/ERR1827057 | ERX1889216 | do7477_p | RNA-Seq | cDNA | TRANSCRIPTOMIC | PAIRED | 737 | 479.787 | ILLUMINA | Illumina HiSeq 2500 | ERP016428 | PRJEB14760 |  | 330944 | ERS1549196 | SAMEA83311168 | simple | 10092 | Mus musculus domesticus | western European house mouse |  |  |  |  | male |  | no |  |  |  |  | CRUK Cambridge Institute Genomics Core Facility | ERA809577 |  | public | E9C97B786441A6C1444CE241C8688DDF | BD1905B93B6F3CD4EFE20A01BF82DD63
ERR1827058 | 2017-02-21 | 2017-02-24 | 3918746 | 979686500 | 3918746 | 250 | 479 |  | https://sra-download.ncbi.nlm.nih.gov/srapub/ERR1827058 | ERX1889217 | do7478_p | RNA-Seq | cDNA | TRANSCRIPTOMIC | PAIRED | 737 | 479.787 | ILLUMINA | Illumina HiSeq 2500 | ERP016428 | PRJEB14760 |  | 330944 | ERS1549197 | SAMEA83311918 | simple | 10092 | Mus musculus domesticus | western European house mouse |  |  |  |  | male |  | no |  |  |  |  | CRUK Cambridge Institute Genomics Core Facility | ERA809577 |  | public | 64395A5CCE6E0FAE216CD331DF6F781F | 887643BFC3AA5A7FB7706F15135D58A7
ERR1827059 | 2017-02-21 | 2017-02-24 | 564568 | 141142000 | 564568 | 250 | 67 |  | https://sra-download.ncbi.nlm.nih.gov/srapub/ERR1827059 | ERX1889218 | do7479_p | RNA-Seq | cDNA | TRANSCRIPTOMIC | PAIRED | 737 | 479.787 | ILLUMINA | Illumina HiSeq 2500 | ERP016428 | PRJEB14760 |  | 330944 | ERS1549198 | SAMEA83312668 | simple | 10092 | Mus musculus domesticus | western European house mouse |  |  |  |  | male |  | no |  |  |  |  | CRUK Cambridge Institute Genomics Core Facility | ERA809577 |  | public | B8DB4E824F7F13416F384BC05D471FC4 | 71E0AD5CFC2DEC363EC9B77EA0BB44D7
ERR1827060 | 2017-02-21 | 2017-02-24 | 5116125 | 1279031250 | 5116125 | 250 | 613 |  | https://sra-download.ncbi.nlm.nih.gov/srapub/ERR1827060 | ERX1889219 | do7480_p | RNA-Seq | cDNA | TRANSCRIPTOMIC | PAIRED | 737 | 479.787 | ILLUMINA | Illumina HiSeq 2500 | ERP016428 | PRJEB14760 |  | 330944 | ERS1549199 | SAMEA83313418 | simple | 10092 | Mus musculus domesticus | western European house mouse |  |  |  |  | male |  | no |  |  |  |  | CRUK Cambridge Institute Genomics Core Facility | ERA809577 |  | public | 7F133B5EA2FCD2E7A37982AC6A380AC9 | 05ABF82D8A4E3DA7BCB900CD44C355BD
ERR1827061 | 2017-02-21 | 2017-02-24 | 6367060 | 1591765000 | 6367060 | 250 | 768 |  | https://sra-download.ncbi.nlm.nih.gov/srapub/ERR1827061 | ERX1889220 | do7481_p | RNA-Seq | cDNA | TRANSCRIPTOMIC | PAIRED | 737 | 479.787 | ILLUMINA | Illumina HiSeq 2500 | ERP016428 | PRJEB14760 |  | 330944 | ERS1549200 | SAMEA83314168 | simple | 10092 | Mus musculus domesticus | western European house mouse |  |  |  |  | male |  | no |  |  |  |  | CRUK Cambridge Institute Genomics Core Facility | ERA809577 |  | public | F5FC5E7C84CEC1EBE1222FEA5CDE5D39 | 0F9D95692095480BD87D6D17629E6717
ERR1827062 | 2017-02-21 | 2017-02-24 | 3655829 | 913957250 | 3655829 | 250 | 460 |  | https://sra-download.ncbi.nlm.nih.gov/srapub/ERR1827062 | ERX1889221 | do7482_p | RNA-Seq | cDNA | TRANSCRIPTOMIC | PAIRED | 737 | 479.787 | ILLUMINA | Illumina HiSeq 2500 | ERP016428 | PRJEB14760 |  | 330944 | ERS1549201 | SAMEA83314918 | simple | 10092 | Mus musculus domesticus | western European house mouse |  |  |  |  | male |  | no |  |  |  |  | CRUK Cambridge Institute Genomics Core Facility | ERA809577 |  | public | 5D1421D69BEE03B8D2A5BEA90751F25C | 1FAC45F05E0BB6E956BFB107A6B206BE
ERR1827063 | 2017-02-21 | 2017-02-24 | 3412223 | 853055750 | 3412223 | 250 | 411 |  | https://sra-download.ncbi.nlm.nih.gov/srapub/ERR1827063 | ERX1889222 | do7483_p | RNA-Seq | cDNA | TRANSCRIPTOMIC | PAIRED | 737 | 479.787 | ILLUMINA | Illumina HiSeq 2500 | ERP016428 | PRJEB14760 |  | 330944 | ERS1549202 | SAMEA83315668 | simple | 10092 | Mus musculus domesticus | western European house mouse |  |  |  |  | male |  | no |  |  |  |  | CRUK Cambridge Institute Genomics Core Facility | ERA809577 |  | public | 3E8AC8BF4D9131A2C56600C03DBC0441 | 9A0E70E0615691BCCF956CC84A2E9F35
ERR1827064 | 2017-02-21 | 2017-02-24 | 2621285 | 655321250 | 2621285 | 250 | 323 |  | https://sra-download.ncbi.nlm.nih.gov/srapub/ERR1827064 | ERX1889223 | do7484_p | RNA-Seq | cDNA | TRANSCRIPTOMIC | PAIRED | 737 | 479.787 | ILLUMINA | Illumina HiSeq 2500 | ERP016428 | PRJEB14760 |  | 330944 | ERS1549203 | SAMEA83316418 | simple | 10092 | Mus musculus domesticus | western European house mouse |  |  |  |  | male |  | no |  |  |  |  | CRUK Cambridge Institute Genomics Core Facility | ERA809577 |  | public | B1E89A61DDB9EBA778494B5DBB1ACF3D | 90B04CC4954912D6E73BC7A63B6C95A8
ERR1827065 | 2017-02-21 | 2017-02-24 | 2683777 | 670944250 | 2683777 | 250 | 329 |  | https://sra-download.ncbi.nlm.nih.gov/srapub/ERR1827065 | ERX1889224 | do7485_p | RNA-Seq | cDNA | TRANSCRIPTOMIC | PAIRED | 737 | 479.787 | ILLUMINA | Illumina HiSeq 2500 | ERP016428 | PRJEB14760 |  | 330944 | ERS1549204 | SAMEA83317168 | simple | 10092 | Mus musculus domesticus | western European house mouse |  |  |  |  | male |  | no |  |  |  |  | CRUK Cambridge Institute Genomics Core Facility | ERA809577 |  | public | 123FD6FEB07F03709E605D593ED58AF8 | 7C56042FF8D3DEC88F66F05081FF4BD0
ERR1827066 | 2017-02-21 | 2017-02-24 | 304208 | 76052000 | 304208 | 250 | 38 |  | https://sra-download.ncbi.nlm.nih.gov/srapub/ERR1827066 | ERX1889225 | do7486_p | RNA-Seq | cDNA | TRANSCRIPTOMIC | PAIRED | 737 | 479.787 | ILLUMINA | Illumina HiSeq 2500 | ERP016428 | PRJEB14760 |  | 330944 | ERS1549205 | SAMEA83317918 | simple | 10092 | Mus musculus domesticus | western European house mouse |  |  |  |  | male |  | no |  |  |  |  | CRUK Cambridge Institute Genomics Core Facility | ERA809577 |  | public | 672C14B0A7EEF1878D60E6F269CDB696 | 85ED783D62EF07C25A580CF1B8AE25D8
ERR1827067 | 2017-02-21 | 2017-02-24 | 3187256 | 796814000 | 3187256 | 250 | 392 |  | https://sra-download.ncbi.nlm.nih.gov/srapub/ERR1827067 | ERX1889226 | do7487_p | RNA-Seq | cDNA | TRANSCRIPTOMIC | PAIRED | 737 | 479.787 | ILLUMINA | Illumina HiSeq 2500 | ERP016428 | PRJEB14760 |  | 330944 | ERS1549206 | SAMEA83318668 | simple | 10092 | Mus musculus domesticus | western European house mouse |  |  |  |  | male |  | no |  |  |  |  | CRUK Cambridge Institute Genomics Core Facility | ERA809577 |  | public | 930C4A5BFD9DBEAF40344E718779658C | D9DD67128E766902D96DFE4A036CF393
ERR1827068 | 2017-02-21 | 2017-02-24 | 359684 | 89921000 | 359684 | 250 | 44 |  | https://sra-download.ncbi.nlm.nih.gov/srapub/ERR1827068 | ERX1889227 | do7488_p | RNA-Seq | cDNA | TRANSCRIPTOMIC | PAIRED | 737 | 479.787 | ILLUMINA | Illumina HiSeq 2500 | ERP016428 | PRJEB14760 |  | 330944 | ERS1549207 | SAMEA83319418 | simple | 10092 | Mus musculus domesticus | western European house mouse |  |  |  |  | male |  | no |  |  |  |  | CRUK Cambridge Institute Genomics Core Facility | ERA809577 |  | public | 9B5681EDCD52DA66FAF0C096CD7F8EA5 | 32BAFEDD8B6413B71CA1FC1C746B2CC9
ERR1827069 | 2017-02-21 | 2017-02-24 | 223988 | 55997000 | 223988 | 250 | 27 |  | https://sra-download.ncbi.nlm.nih.gov/srapub/ERR1827069 | ERX1889228 | do7489_p | RNA-Seq | cDNA | TRANSCRIPTOMIC | PAIRED | 737 | 479.787 | ILLUMINA | Illumina HiSeq 2500 | ERP016428 | PRJEB14760 |  | 330944 | ERS1549208 | SAMEA83320168 | simple | 10092 | Mus musculus domesticus | western European house mouse |  |  |  |  | male |  | no |  |  |  |  | CRUK Cambridge Institute Genomics Core Facility | ERA809577 |  | public | 126D14D66084505354D1CEE1D58757FC | DE099C969463CACA8E8A695D20701DB9
ERR1827070 | 2017-02-21 | 2017-02-24 | 4429088 | 1107272000 | 4429088 | 250 | 528 |  | https://sra-download.ncbi.nlm.nih.gov/srapub/ERR1827070 | ERX1889229 | do7490_p | RNA-Seq | cDNA | TRANSCRIPTOMIC | PAIRED | 737 | 479.787 | ILLUMINA | Illumina HiSeq 2500 | ERP016428 | PRJEB14760 |  | 330944 | ERS1549209 | SAMEA83320918 | simple | 10092 | Mus musculus domesticus | western European house mouse |  |  |  |  | male |  | no |  |  |  |  | CRUK Cambridge Institute Genomics Core Facility | ERA809577 |  | public | ECF27B6E7F4FB7789A984BC1D711C4C6 | FFC6E3A45D91078232F34BEC9473B6C4
ERR1827071 | 2017-02-21 | 2017-02-24 | 4701548 | 1175387000 | 4701548 | 250 | 562 |  | https://sra-download.ncbi.nlm.nih.gov/srapub/ERR1827071 | ERX1889230 | do7491_p | RNA-Seq | cDNA | TRANSCRIPTOMIC | PAIRED | 737 | 479.787 | ILLUMINA | Illumina HiSeq 2500 | ERP016428 | PRJEB14760 |  | 330944 | ERS1549210 | SAMEA83321668 | simple | 10092 | Mus musculus domesticus | western European house mouse |  |  |  |  | male |  | no |  |  |  |  | CRUK Cambridge Institute Genomics Core Facility | ERA809577 |  | public | F032C8AC4A5EAF2B19B82CDB47279ABE | 568F68A2FC44A8D799E682C52031E8C5
ERR1827072 | 2017-02-21 | 2017-02-24 | 451790 | 112947500 | 451790 | 250 | 54 |  | https://sra-download.ncbi.nlm.nih.gov/srapub/ERR1827072 | ERX1889231 | do7492_p | RNA-Seq | cDNA | TRANSCRIPTOMIC | PAIRED | 737 | 479.787 | ILLUMINA | Illumina HiSeq 2500 | ERP016428 | PRJEB14760 |  | 330944 | ERS1549211 | SAMEA83322418 | simple | 10092 | Mus musculus domesticus | western European house mouse |  |  |  |  | male |  | no |  |  |  |  | CRUK Cambridge Institute Genomics Core Facility | ERA809577 |  | public | 87043A8D986E698C7B66A0600ACC440F | 7C26035889A9BA04F3FF34B5AE6AE6DD
ERR1827073 | 2017-02-21 | 2017-02-24 | 4798589 | 1199647250 | 4798589 | 250 | 571 |  | https://sra-download.ncbi.nlm.nih.gov/srapub/ERR1827073 | ERX1889232 | do7493_p | RNA-Seq | cDNA | TRANSCRIPTOMIC | PAIRED | 737 | 479.787 | ILLUMINA | Illumina HiSeq 2500 | ERP016428 | PRJEB14760 |  | 330944 | ERS1549212 | SAMEA83323168 | simple | 10092 | Mus musculus domesticus | western European house mouse |  |  |  |  | male |  | no |  |  |  |  | CRUK Cambridge Institute Genomics Core Facility | ERA809577 |  | public | 095DFE7574A019127B9C40AE3151B59A | F055F6ACC8CEB3E743F8DA5196D0B2C8
ERR1827074 | 2017-02-21 | 2017-02-24 | 5974287 | 1493571750 | 5974287 | 250 | 718 |  | https://sra-download.ncbi.nlm.nih.gov/srapub/ERR1827074 | ERX1889233 | do7494_p | RNA-Seq | cDNA | TRANSCRIPTOMIC | PAIRED | 737 | 479.787 | ILLUMINA | Illumina HiSeq 2500 | ERP016428 | PRJEB14760 |  | 330944 | ERS1549213 | SAMEA83323918 | simple | 10092 | Mus musculus domesticus | western European house mouse |  |  |  |  | male |  | no |  |  |  |  | CRUK Cambridge Institute Genomics Core Facility | ERA809577 |  | public | 8BF72F9B7BDE53E3DFE189962BAB77D8 | EF67F5D5F12E627FC648CA2C5E00FAE1
ERR1827075 | 2017-02-21 | 2017-02-24 | 5343108 | 1335777000 | 5343108 | 250 | 625 |  | https://sra-download.ncbi.nlm.nih.gov/srapub/ERR1827075 | ERX1889234 | do7495_p | RNA-Seq | cDNA | TRANSCRIPTOMIC | PAIRED | 737 | 479.787 | ILLUMINA | Illumina HiSeq 2500 | ERP016428 | PRJEB14760 |  | 330944 | ERS1549214 | SAMEA83324668 | simple | 10092 | Mus musculus domesticus | western European house mouse |  |  |  |  | male |  | no |  |  |  |  | CRUK Cambridge Institute Genomics Core Facility | ERA809577 |  | public | 881324F6C3E9E9DBE8D0A5D39BB93783 | 3E9B7B200896729A695B9D234A5887FF
ERR1827076 | 2017-02-21 | 2017-02-24 | 4022583 | 1005645750 | 4022583 | 250 | 489 |  | https://sra-download.ncbi.nlm.nih.gov/srapub/ERR1827076 | ERX1889235 | do7496_p | RNA-Seq | cDNA | TRANSCRIPTOMIC | PAIRED | 737 | 479.787 | ILLUMINA | Illumina HiSeq 2500 | ERP016428 | PRJEB14760 |  | 330944 | ERS1549215 | SAMEA83325418 | simple | 10092 | Mus musculus domesticus | western European house mouse |  |  |  |  | male |  | no |  |  |  |  | CRUK Cambridge Institute Genomics Core Facility | ERA809577 |  | public | 3E143DBD8CEF2C76925F24393121F227 | C6105751FB9716E4D2A8F7FC9B7CDAD8
ERR1827077 | 2017-02-21 | 2017-02-24 | 3506477 | 876619250 | 3506477 | 250 | 426 |  | https://sra-download.ncbi.nlm.nih.gov/srapub/ERR1827077 | ERX1889236 | do7497_p | RNA-Seq | cDNA | TRANSCRIPTOMIC | PAIRED | 737 | 479.787 | ILLUMINA | Illumina HiSeq 2500 | ERP016428 | PRJEB14760 |  | 330944 | ERS1549216 | SAMEA83326168 | simple | 10092 | Mus musculus domesticus | western European house mouse |  |  |  |  | male |  | no |  |  |  |  | CRUK Cambridge Institute Genomics Core Facility | ERA809577 |  | public | DE976D5AF75CC13D735F0A6A563BB6BB | E09DC0CBE8E18CF7ECF7ADA9F6D1965B
ERR1827078 | 2017-02-21 | 2017-02-24 | 2797074 | 699268500 | 2797074 | 250 | 346 |  | https://sra-download.ncbi.nlm.nih.gov/srapub/ERR1827078 | ERX1889237 | do7498_p | RNA-Seq | cDNA | TRANSCRIPTOMIC | PAIRED | 737 | 479.787 | ILLUMINA | Illumina HiSeq 2500 | ERP016428 | PRJEB14760 |  | 330944 | ERS1549217 | SAMEA83326918 | simple | 10092 | Mus musculus domesticus | western European house mouse |  |  |  |  | male |  | no |  |  |  |  | CRUK Cambridge Institute Genomics Core Facility | ERA809577 |  | public | E006D1737DE13AC0D6974DBD7AE6761E | 10AAD2FC4DECC2CD8B7EAEE49BB5CAC8
ERR1827079 | 2017-02-21 | 2017-02-24 | 2842339 | 710584750 | 2842339 | 250 | 357 |  | https://sra-download.ncbi.nlm.nih.gov/srapub/ERR1827079 | ERX1889238 | do7499_p | RNA-Seq | cDNA | TRANSCRIPTOMIC | PAIRED | 737 | 479.787 | ILLUMINA | Illumina HiSeq 2500 | ERP016428 | PRJEB14760 |  | 330944 | ERS1549218 | SAMEA83327668 | simple | 10092 | Mus musculus domesticus | western European house mouse |  |  |  |  | male |  | no |  |  |  |  | CRUK Cambridge Institute Genomics Core Facility | ERA809577 |  | public | FE51BBCD1A7F41971D57981484F83CA7 | 52964DA74967746EF9D0FD22DD8116F2
ERR1827080 | 2017-02-21 | 2017-02-24 | 3424008 | 856002000 | 3424008 | 250 | 428 |  | https://sra-download.ncbi.nlm.nih.gov/srapub/ERR1827080 | ERX1889239 | do7500_p | RNA-Seq | cDNA | TRANSCRIPTOMIC | PAIRED | 737 | 479.787 | ILLUMINA | Illumina HiSeq 2500 | ERP016428 | PRJEB14760 |  | 330944 | ERS1549219 | SAMEA83328418 | simple | 10092 | Mus musculus domesticus | western European house mouse |  |  |  |  | male |  | no |  |  |  |  | CRUK Cambridge Institute Genomics Core Facility | ERA809577 |  | public | 1181D68401B51659E0FC14A813F459A0 | 9BD308472DDEF8A2CAE7389B260D742F
ERR1827081 | 2017-02-21 | 2017-02-24 | 4339496 | 1084874000 | 4339496 | 250 | 539 |  | https://sra-download.ncbi.nlm.nih.gov/srapub/ERR1827081 | ERX1889240 | do7501_p | RNA-Seq | cDNA | TRANSCRIPTOMIC | PAIRED | 737 | 479.787 | ILLUMINA | Illumina HiSeq 2500 | ERP016428 | PRJEB14760 |  | 330944 | ERS1549220 | SAMEA83329168 | simple | 10092 | Mus musculus domesticus | western European house mouse |  |  |  |  | male |  | no |  |  |  |  | CRUK Cambridge Institute Genomics Core Facility | ERA809577 |  | public | 5E58050A4251A2D91C744AA1D1916893 | 5546E1D82EEC6D97C80D30C9482E9033
ERR1827082 | 2017-02-21 | 2017-02-24 | 3674020 | 918505000 | 3674020 | 250 | 459 |  | https://sra-download.ncbi.nlm.nih.gov/srapub/ERR1827082 | ERX1889241 | do7502_p | RNA-Seq | cDNA | TRANSCRIPTOMIC | PAIRED | 737 | 479.787 | ILLUMINA | Illumina HiSeq 2500 | ERP016428 | PRJEB14760 |  | 330944 | ERS1549221 | SAMEA83329918 | simple | 10092 | Mus musculus domesticus | western European house mouse |  |  |  |  | male |  | no |  |  |  |  | CRUK Cambridge Institute Genomics Core Facility | ERA809577 |  | public | 9E9A7E91FCE9958C0A53BE69945D4352 | F54425A84444A6F306E6BBF7D6CD735F
ERR1827083 | 2017-02-21 | 2017-02-24 | 3845756 | 961439000 | 3845756 | 250 | 473 |  | https://sra-download.ncbi.nlm.nih.gov/srapub/ERR1827083 | ERX1889242 | do7503_p | RNA-Seq | cDNA | TRANSCRIPTOMIC | PAIRED | 737 | 479.787 | ILLUMINA | Illumina HiSeq 2500 | ERP016428 | PRJEB14760 |  | 330944 | ERS1549222 | SAMEA83330668 | simple | 10092 | Mus musculus domesticus | western European house mouse |  |  |  |  | male |  | no |  |  |  |  | CRUK Cambridge Institute Genomics Core Facility | ERA809577 |  | public | 746985C7B62DD8E9C1815114F29CDDF8 | 0332AE6CF79BBF4A810F5D5E8EADA4E8
ERR1827084 | 2017-02-21 | 2017-02-24 | 4023721 | 1005930250 | 4023721 | 250 | 499 |  | https://sra-download.ncbi.nlm.nih.gov/srapub/ERR1827084 | ERX1889243 | do7504_p | RNA-Seq | cDNA | TRANSCRIPTOMIC | PAIRED | 737 | 479.787 | ILLUMINA | Illumina HiSeq 2500 | ERP016428 | PRJEB14760 |  | 330944 | ERS1549223 | SAMEA83331418 | simple | 10092 | Mus musculus domesticus | western European house mouse |  |  |  |  | male |  | no |  |  |  |  | CRUK Cambridge Institute Genomics Core Facility | ERA809577 |  | public | 823A79BE533DEDF0540F21093FEC38CB | D9BAD8AAD6F1C3C0AAE90325B103730F
ERR1827085 | 2017-02-21 | 2017-02-24 | 4290241 | 1072560250 | 4290241 | 250 | 531 |  | https://sra-download.ncbi.nlm.nih.gov/srapub/ERR1827085 | ERX1889244 | do7505_p | RNA-Seq | cDNA | TRANSCRIPTOMIC | PAIRED | 737 | 479.787 | ILLUMINA | Illumina HiSeq 2500 | ERP016428 | PRJEB14760 |  | 330944 | ERS1549224 | SAMEA83332168 | simple | 10092 | Mus musculus domesticus | western European house mouse |  |  |  |  | male |  | no |  |  |  |  | CRUK Cambridge Institute Genomics Core Facility | ERA809577 |  | public | E7120604DDDDBEE103A3A6875DAFD2C8 | 1263FE113CE82DD808102B569A874744
ERR1827086 | 2017-02-21 | 2017-02-24 | 3748934 | 937233500 | 3748934 | 250 | 473 |  | https://sra-download.ncbi.nlm.nih.gov/srapub/ERR1827086 | ERX1889245 | do7506_p | RNA-Seq | cDNA | TRANSCRIPTOMIC | PAIRED | 737 | 479.787 | ILLUMINA | Illumina HiSeq 2500 | ERP016428 | PRJEB14760 |  | 330944 | ERS1549225 | SAMEA83332918 | simple | 10092 | Mus musculus domesticus | western European house mouse |  |  |  |  | male |  | no |  |  |  |  | CRUK Cambridge Institute Genomics Core Facility | ERA809577 |  | public | EB198AA746D95A3B398F73D2675AD642 | F09865EABAF9B19B2EC405A84209F396
ERR1827087 | 2017-02-21 | 2017-02-24 | 4174644 | 1043661000 | 4174644 | 250 | 506 |  | https://sra-download.ncbi.nlm.nih.gov/srapub/ERR1827087 | ERX1889246 | do7507_p | RNA-Seq | cDNA | TRANSCRIPTOMIC | PAIRED | 737 | 479.787 | ILLUMINA | Illumina HiSeq 2500 | ERP016428 | PRJEB14760 |  | 330944 | ERS1549226 | SAMEA83333668 | simple | 10092 | Mus musculus domesticus | western European house mouse |  |  |  |  | male |  | no |  |  |  |  | CRUK Cambridge Institute Genomics Core Facility | ERA809577 |  | public | 34DFB1E28E053F6395FC4A025D826867 | 1FBDB2E19D0C9333CA6876A0E76083EE
ERR1827088 | 2017-02-21 | 2017-02-24 | 186004 | 46501000 | 186004 | 250 | 24 |  | https://sra-download.ncbi.nlm.nih.gov/srapub/ERR1827088 | ERX1889247 | do7508_p | RNA-Seq | cDNA | TRANSCRIPTOMIC | PAIRED | 737 | 479.787 | ILLUMINA | Illumina HiSeq 2500 | ERP016428 | PRJEB14760 |  | 330944 | ERS1549227 | SAMEA83334418 | simple | 10092 | Mus musculus domesticus | western European house mouse |  |  |  |  | male |  | no |  |  |  |  | CRUK Cambridge Institute Genomics Core Facility | ERA809577 |  | public | 7B951EABAC4DB50E05ACDB52E1B4F143 | 0831B446223CFEA818BAF53BF48261E7
ERR1827089 | 2017-02-21 | 2017-02-24 | 3001181 | 750295250 | 3001181 | 250 | 377 |  | https://sra-download.ncbi.nlm.nih.gov/srapub/ERR1827089 | ERX1889248 | do7509_p | RNA-Seq | cDNA | TRANSCRIPTOMIC | PAIRED | 737 | 479.787 | ILLUMINA | Illumina HiSeq 2500 | ERP016428 | PRJEB14760 |  | 330944 | ERS1549228 | SAMEA83335168 | simple | 10092 | Mus musculus domesticus | western European house mouse |  |  |  |  | male |  | no |  |  |  |  | CRUK Cambridge Institute Genomics Core Facility | ERA809577 |  | public | EA25116B105B9DA42BEB0624615C1EA9 | 91895C9F466608CA85264F46BC73016A
ERR1827090 | 2017-02-21 | 2017-02-24 | 256589 | 64147250 | 256589 | 250 | 32 |  | https://sra-download.ncbi.nlm.nih.gov/srapub/ERR1827090 | ERX1889249 | do7510_p | RNA-Seq | cDNA | TRANSCRIPTOMIC | PAIRED | 737 | 479.787 | ILLUMINA | Illumina HiSeq 2500 | ERP016428 | PRJEB14760 |  | 330944 | ERS1549229 | SAMEA83335918 | simple | 10092 | Mus musculus domesticus | western European house mouse |  |  |  |  | male |  | no |  |  |  |  | CRUK Cambridge Institute Genomics Core Facility | ERA809577 |  | public | C267444E2C22ADE368785F693CF16757 | 574D25CAF2E214D1499A7FD093F47BE5
ERR1827091 | 2017-02-21 | 2017-02-24 | 2974212 | 743553000 | 2974212 | 250 | 372 |  | https://sra-download.ncbi.nlm.nih.gov/srapub/ERR1827091 | ERX1889250 | do7511_p | RNA-Seq | cDNA | TRANSCRIPTOMIC | PAIRED | 737 | 479.787 | ILLUMINA | Illumina HiSeq 2500 | ERP016428 | PRJEB14760 |  | 330944 | ERS1549230 | SAMEA83336668 | simple | 10092 | Mus musculus domesticus | western European house mouse |  |  |  |  | male |  | no |  |  |  |  | CRUK Cambridge Institute Genomics Core Facility | ERA809577 |  | public | 04BA28F7CF7CA4E591552280791F3BC1 | 054B924BA2CD7F4DCCFB6343C5FB324B
ERR1827092 | 2017-02-21 | 2017-02-24 | 4056925 | 1014231250 | 4056925 | 250 | 494 |  | https://sra-download.ncbi.nlm.nih.gov/srapub/ERR1827092 | ERX1889251 | do7512_p | RNA-Seq | cDNA | TRANSCRIPTOMIC | PAIRED | 737 | 479.787 | ILLUMINA | Illumina HiSeq 2500 | ERP016428 | PRJEB14760 |  | 330944 | ERS1549231 | SAMEA83337418 | simple | 10092 | Mus musculus domesticus | western European house mouse |  |  |  |  | male |  | no |  |  |  |  | CRUK Cambridge Institute Genomics Core Facility | ERA809577 |  | public | B422717422D84ECCA7C67196800C9B1C | 6EFEBBE39EF747028661522970BB3558
ERR1827093 | 2017-02-21 | 2017-02-24 | 289058 | 72264500 | 289058 | 250 | 36 |  | https://sra-download.ncbi.nlm.nih.gov/srapub/ERR1827093 | ERX1889252 | do7513_p | RNA-Seq | cDNA | TRANSCRIPTOMIC | PAIRED | 737 | 479.787 | ILLUMINA | Illumina HiSeq 2500 | ERP016428 | PRJEB14760 |  | 330944 | ERS1549232 | SAMEA83338168 | simple | 10092 | Mus musculus domesticus | western European house mouse |  |  |  |  | male |  | no |  |  |  |  | CRUK Cambridge Institute Genomics Core Facility | ERA809577 |  | public | D5E1A2D62F0F044E2B14EBCC75B6A1AC | C8A4C592E87FC380D51EA7CE7B6F052F
ERR1827094 | 2017-02-21 | 2017-02-24 | 3058480 | 764620000 | 3058480 | 250 | 387 |  | https://sra-download.ncbi.nlm.nih.gov/srapub/ERR1827094 | ERX1889253 | do7514_p | RNA-Seq | cDNA | TRANSCRIPTOMIC | PAIRED | 737 | 479.787 | ILLUMINA | Illumina HiSeq 2500 | ERP016428 | PRJEB14760 |  | 330944 | ERS1549233 | SAMEA83338918 | simple | 10092 | Mus musculus domesticus | western European house mouse |  |  |  |  | male |  | no |  |  |  |  | CRUK Cambridge Institute Genomics Core Facility | ERA809577 |  | public | FE900B58AB6CED6E78E81450EDED2A8D | 06A097905E358AD751A44AB812042E6E
ERR1827095 | 2017-02-21 | 2017-02-24 | 3262768 | 815692000 | 3262768 | 250 | 407 |  | https://sra-download.ncbi.nlm.nih.gov/srapub/ERR1827095 | ERX1889254 | do7515_p | RNA-Seq | cDNA | TRANSCRIPTOMIC | PAIRED | 737 | 479.787 | ILLUMINA | Illumina HiSeq 2500 | ERP016428 | PRJEB14760 |  | 330944 | ERS1549234 | SAMEA83339668 | simple | 10092 | Mus musculus domesticus | western European house mouse |  |  |  |  | male |  | no |  |  |  |  | CRUK Cambridge Institute Genomics Core Facility | ERA809577 |  | public | 4A6DFF096CC1F20874DBD79A4A4A80E1 | 3ED5335400B5B5DD9491F9A955F92F8E
ERR1827096 | 2017-02-21 | 2017-02-24 | 2960597 | 740149250 | 2960597 | 250 | 369 |  | https://sra-download.ncbi.nlm.nih.gov/srapub/ERR1827096 | ERX1889255 | do7516_p | RNA-Seq | cDNA | TRANSCRIPTOMIC | PAIRED | 737 | 479.787 | ILLUMINA | Illumina HiSeq 2500 | ERP016428 | PRJEB14760 |  | 330944 | ERS1549235 | SAMEA83340418 | simple | 10092 | Mus musculus domesticus | western European house mouse |  |  |  |  | male |  | no |  |  |  |  | CRUK Cambridge Institute Genomics Core Facility | ERA809577 |  | public | 9C356DF3B5CC91E3C65974D25C81BA3C | 905A52C39635ACFB072EB9DE1957B4A6
ERR1827097 | 2017-02-21 | 2017-02-24 | 388777 | 97194250 | 388777 | 250 | 49 |  | https://sra-download.ncbi.nlm.nih.gov/srapub/ERR1827097 | ERX1889256 | do7517_p | RNA-Seq | cDNA | TRANSCRIPTOMIC | PAIRED | 737 | 479.787 | ILLUMINA | Illumina HiSeq 2500 | ERP016428 | PRJEB14760 |  | 330944 | ERS1549236 | SAMEA83341168 | simple | 10092 | Mus musculus domesticus | western European house mouse |  |  |  |  | male |  | no |  |  |  |  | CRUK Cambridge Institute Genomics Core Facility | ERA809577 |  | public | 56F28F7334A6FF4B3B03904B5205E6FC | 2BAF0B52572B1C65AA9B8C3CDFB05C21
ERR1827098 | 2017-02-21 | 2017-02-24 | 3079657 | 769914250 | 3079657 | 250 | 388 |  | https://sra-download.ncbi.nlm.nih.gov/srapub/ERR1827098 | ERX1889257 | do7518_p | RNA-Seq | cDNA | TRANSCRIPTOMIC | PAIRED | 737 | 479.787 | ILLUMINA | Illumina HiSeq 2500 | ERP016428 | PRJEB14760 |  | 330944 | ERS1549237 | SAMEA83341918 | simple | 10092 | Mus musculus domesticus | western European house mouse |  |  |  |  | male |  | no |  |  |  |  | CRUK Cambridge Institute Genomics Core Facility | ERA809577 |  | public | F424FE05D045F9195006F3CACC347C88 | 331DF2BBB0E9615544AFA8F76D9372DF
ERR1827099 | 2017-02-21 | 2017-02-24 | 258055 | 64513750 | 258055 | 250 | 32 |  | https://sra-download.ncbi.nlm.nih.gov/srapub/ERR1827099 | ERX1889258 | do7519_p | RNA-Seq | cDNA | TRANSCRIPTOMIC | PAIRED | 737 | 479.787 | ILLUMINA | Illumina HiSeq 2500 | ERP016428 | PRJEB14760 |  | 330944 | ERS1549238 | SAMEA83342668 | simple | 10092 | Mus musculus domesticus | western European house mouse |  |  |  |  | male |  | no |  |  |  |  | CRUK Cambridge Institute Genomics Core Facility | ERA809577 |  | public | F7B5FDA1427E83704BA647D2212BB816 | E223D345110BF04283CB16206C9E40A6
ERR1827100 | 2017-02-21 | 2017-02-24 | 2269000 | 567250000 | 2269000 | 250 | 286 |  | https://sra-download.ncbi.nlm.nih.gov/srapub/ERR1827100 | ERX1889259 | do7520_p | RNA-Seq | cDNA | TRANSCRIPTOMIC | PAIRED | 737 | 479.787 | ILLUMINA | Illumina HiSeq 2500 | ERP016428 | PRJEB14760 |  | 330944 | ERS1549239 | SAMEA83343418 | simple | 10092 | Mus musculus domesticus | western European house mouse |  |  |  |  | male |  | no |  |  |  |  | CRUK Cambridge Institute Genomics Core Facility | ERA809577 |  | public | E79C5393CEBE4CBD4C9519CB42BB7240 | E5E913B47E9E4FA3CEB48FD32CCBA1C9
ERR1827101 | 2017-02-21 | 2017-02-24 | 2943715 | 735928750 | 2943715 | 250 | 371 |  | https://sra-download.ncbi.nlm.nih.gov/srapub/ERR1827101 | ERX1889260 | do7521_p | RNA-Seq | cDNA | TRANSCRIPTOMIC | PAIRED | 737 | 479.787 | ILLUMINA | Illumina HiSeq 2500 | ERP016428 | PRJEB14760 |  | 330944 | ERS1549240 | SAMEA83344168 | simple | 10092 | Mus musculus domesticus | western European house mouse |  |  |  |  | male |  | no |  |  |  |  | CRUK Cambridge Institute Genomics Core Facility | ERA809577 |  | public | 661BA1003E40E0EFD914C0C4E2DDC98B | F0A76193D04BD7A8C1C0CA543F91578D
ERR1827102 | 2017-02-21 | 2017-02-24 | 3187013 | 796753250 | 3187013 | 250 | 397 |  | https://sra-download.ncbi.nlm.nih.gov/srapub/ERR1827102 | ERX1889261 | do7522_p | RNA-Seq | cDNA | TRANSCRIPTOMIC | PAIRED | 737 | 479.787 | ILLUMINA | Illumina HiSeq 2500 | ERP016428 | PRJEB14760 |  | 330944 | ERS1549241 | SAMEA83344918 | simple | 10092 | Mus musculus domesticus | western European house mouse |  |  |  |  | male |  | no |  |  |  |  | CRUK Cambridge Institute Genomics Core Facility | ERA809577 |  | public | 7A1010B1A88D69BEEDE619E6CF229EDE | 62A2BEB41C4EFE4B784E0C51CD93CC74
ERR1827103 | 2017-02-21 | 2017-02-24 | 3129370 | 782342500 | 3129370 | 250 | 388 |  | https://sra-download.ncbi.nlm.nih.gov/srapub/ERR1827103 | ERX1889262 | do7523_p | RNA-Seq | cDNA | TRANSCRIPTOMIC | PAIRED | 737 | 479.787 | ILLUMINA | Illumina HiSeq 2500 | ERP016428 | PRJEB14760 |  | 330944 | ERS1549242 | SAMEA83345668 | simple | 10092 | Mus musculus domesticus | western European house mouse |  |  |  |  | male |  | no |  |  |  |  | CRUK Cambridge Institute Genomics Core Facility | ERA809577 |  | public | 76468D62C1C5F804620351F21FC20351 | 691BC7DCF6A615A61E132A92FDB57422
ERR1827104 | 2017-02-21 | 2017-02-24 | 3683795 | 920948750 | 3683795 | 250 | 456 |  | https://sra-download.ncbi.nlm.nih.gov/srapub/ERR1827104 | ERX1889263 | do7524_p | RNA-Seq | cDNA | TRANSCRIPTOMIC | PAIRED | 737 | 479.787 | ILLUMINA | Illumina HiSeq 2500 | ERP016428 | PRJEB14760 |  | 330944 | ERS1549243 | SAMEA83346418 | simple | 10092 | Mus musculus domesticus | western European house mouse |  |  |  |  | male |  | no |  |  |  |  | CRUK Cambridge Institute Genomics Core Facility | ERA809577 |  | public | 7BD292D98B14B293A15DC9962D938695 | C69FBF4B710D53BC505C026594E59D73
ERR1827105 | 2017-02-21 | 2017-02-24 | 3514621 | 878655250 | 3514621 | 250 | 432 |  | https://sra-download.ncbi.nlm.nih.gov/srapub/ERR1827105 | ERX1889264 | do7525_p | RNA-Seq | cDNA | TRANSCRIPTOMIC | PAIRED | 737 | 479.787 | ILLUMINA | Illumina HiSeq 2500 | ERP016428 | PRJEB14760 |  | 330944 | ERS1549244 | SAMEA83347168 | simple | 10092 | Mus musculus domesticus | western European house mouse |  |  |  |  | male |  | no |  |  |  |  | CRUK Cambridge Institute Genomics Core Facility | ERA809577 |  | public | FEA934D86C7E3C8C2D67502EFC8C47A2 | B9B7701EAA311D4998F9A41F0FE29943
ERR1827106 | 2017-02-21 | 2017-02-24 | 3235702 | 808925500 | 3235702 | 250 | 396 |  | https://sra-download.ncbi.nlm.nih.gov/srapub/ERR1827106 | ERX1889265 | do7526_p | RNA-Seq | cDNA | TRANSCRIPTOMIC | PAIRED | 737 | 479.787 | ILLUMINA | Illumina HiSeq 2500 | ERP016428 | PRJEB14760 |  | 330944 | ERS1549245 | SAMEA83347918 | simple | 10092 | Mus musculus domesticus | western European house mouse |  |  |  |  | male |  | no |  |  |  |  | CRUK Cambridge Institute Genomics Core Facility | ERA809577 |  | public | 1ACCE469D2A5C88D9359034ED493FD86 | B214A6216AA1FBB7BCF6FB6E5CBCD2F1
