diekhans/pycbio/tests/libtests/pycbio/ncbi/input/GCF_000001405.39_GRCh38.p13_assembly_report.txt

# Assembly name:  GRCh38.p13
# Description:    Genome Reference Consortium Human Build 38 patch release 13 (GRCh38.p13)
# Organism name:  Homo sapiens (human)
# Taxid:          9606
# BioProject:     PRJNA31257
# Submitter:      Genome Reference Consortium
# Date:           2019-02-28
# Synonyms:       hg38	
# Assembly type:  haploid-with-alt-loci
# Release type:   patch
# Assembly level: Chromosome
# Genome representation: full
# RefSeq category: Reference Genome
# GenBank assembly accession: GCA_000001405.28
# RefSeq assembly accession: GCF_000001405.39
# RefSeq assembly and GenBank assemblies identical: no
#
## Assembly-Units:
## GenBank Unit Accession	RefSeq Unit Accession	Assembly-Unit name
## GCA_000001305.2	GCF_000001305.15	Primary Assembly
## GCA_000005045.26	GCF_000005045.25	PATCHES
## GCA_000001315.2	GCF_000001315.2	ALT_REF_LOCI_1
## GCA_000006015.1	GCF_000006015.1	non-nuclear
#
# Ordered by chromosome/plasmid; the chromosomes/plasmids are followed by
# unlocalized scaffolds.
# Unplaced scaffolds are listed at the end.
# RefSeq is equal or derived from GenBank object.
#
# Sequence-Name	Sequence-Role	Assigned-Molecule	Assigned-Molecule-Location/Type	GenBank-Accn	Relationship	RefSeq-Accn	Assembly-Unit	Sequence-Length	UCSC-style-name
1	assembled-molecule	1	Chromosome	CM000663.2	=	NC_000001.11	Primary Assembly	248956422	chr1
2	assembled-molecule	2	Chromosome	CM000664.2	=	NC_000002.12	Primary Assembly	242193529	chr2
MT	assembled-molecule	MT	Mitochondrion	J01415.2	=	NC_012920.1	non-nuclear	16569	chrM
HSCHRUN_RANDOM_CTG29	unplaced-scaffold	na	na	KI270752.1	<>	na	Primary Assembly	27745	chrUn_KI270752v1
