diekhans/pycbio/tests/libtests/pycbio/ncbi/input/GCF_000001405.28.assembly.txt

# Assembly Name:  GRCh38.p2
# Description:    Genome Reference Consortium Human Build 38 patch release 2 (GRCh38.p2)
# Organism name:  Homo sapiens
# Taxid:          9606
# Submitter:      Genome Reference Consortium
# Date:           2014-12-5
# Assembly type:  haploid-with-alt-loci
# Release type:   patch
# Assembly level: Chromosome
# Genome representation: full
# GenBank Assembly Accession: GCA_000001405.17 (replaced)
# RefSeq Assembly Accession: GCF_000001405.28 (species-representative replaced)
# RefSeq Assembly and GenBank Assemblies Identical: yes
#
## Assembly-Units:
## GenBank Unit Accession	RefSeq Unit Accession	Assembly-Unit name
## GCA_000001305.2	GCF_000001305.14	Primary Assembly
## GCA_000005045.15	GCF_000005045.14	PATCHES
## GCA_000001315.2	GCF_000001315.2	ALT_REF_LOCI_1
## GCA_000001325.2	GCF_000001325.3	ALT_REF_LOCI_2
## GCA_000001335.2	GCF_000001335.2	ALT_REF_LOCI_3
## GCA_000006015.1	GCF_000006015.1	non-nuclear
#
# Ordered by chromosome/plasmid; the chromosomes/plasmids are followed by
# unlocalized scaffolds.
# Unplaced scaffolds are listed at the end.
# RefSeq is equal or derived from GenBank object.
#
# Sequence-Name	Sequence-Role	Assigned-Molecule	Assigned-Molecule-Location/Type	GenBank-Accn	Relationship	RefSeq-Accn	Assembly-Unit	Sequence-Length	UCSC-style-name
1	assembled-molecule	1	Chromosome	CM000663.2	=	NC_000001.11	Primary Assembly	249698942	chr1
2	assembled-molecule	2	Chromosome	CM000664.2	=	NC_000002.12	Primary Assembly	242508799	chr2
3	assembled-molecule	3	Chromosome	CM000665.2	=	NC_000003.12	Primary Assembly	198450956	chr3
Y	assembled-molecule	Y	Chromosome	CM000686.2	=	NC_000024.10	Primary Assembly	57264655	chrY
HSCHR1_CTG1_UNLOCALIZED	unlocalized-scaffold	1	Chromosome	KI270706.1	=	NT_187361.1	Primary Assembly	175055	chr1_KI270706v1_random
HSCHRUN_RANDOM_CTG34	unplaced-scaffold	na	na	KI270755.1	=	NT_187510.1	Primary Assembly	36723	chrUn_KI270755v1
HG986_PATCH	fix-patch	1	Chromosome	KN196472.1	=	NW_009646194.1	PATCHES	186494	na
HSCHR5_7_CTG1	novel-patch	5	Chromosome	KN196477.1	=	NW_009646199.1	PATCHES	139087	na
HG2128_PATCH	fix-patch	6	Chromosome	KN196478.1	=	NW_009646200.1	PATCHES	268330	na
HSCHR19KIR_T7526_BDEL_HAP_CTG3_1	alt-scaffold	19	Chromosome	KI270916.1	=	NT_187670.1	ALT_REF_LOCI_22	184516	chr19_KI270916v1_alt
MT	assembled-molecule	MT	Mitochondrion	J01415.2	=	NC_012920.1	non-nuclear	16569	chrM
