diekhans/pycbio/tests/data/README.org

Common test data

* generate gnome teat regions:
** create a BED4 for the region
** extract sequence with
twoBitToFa -bedPos -bed=
** rename name regions to be in the form:
chr19_51887540_51906200
** BLAT to get mappings of region to genome
blat -q=dna -t=dna -noHead the.2bit:chr1 region.fa reg1.psl
** pick best alignments
** project annotations with either
- pslMap: use -swapMap to project to region
- liftOver: swapPsl and pslToChain
- CrossMap for BAMs

* Human genome regions

** selected regions of GRCh38
*** grch38-regions.fa
grch38-regions-map.psl - mappings of regions to GRCh38
create with BLAT and pick best alignment
use pslMap -swapMap to project to region

*** regions:
**** chr19_51887540_51906200 ZNF649 18660bp region
