diekhans/pycbio/tests/progtests/spreadSheets/input/H9_haplotype_enriched_peaks_atac-seq.xlsx

Sheet: H9_q20_hap1_enriched_peaks
Chr | Start | End | Strand | Peak Score | Focus Ratio/Region Size | Annotation | Detailed Annotation | Distance to TSS | Nearest PromoterID | Entrez ID | Nearest Unigene
chr5_hap1 | 699943 | 700327 | + | -1.202447746 | NA | promoter-TSS (TPPP) | -promoter-TSS (TPPP) | 168 | ENSG00000289088 | ENSG00000289088 | H9_HAP1_T0375776
chr14_hap1 | 69301090 | 69301579 | + | -1.270380518 | NA | exon (NT5CP1, exon 1 of 1) | -exon (NT5CP1, exon 1 of 1) | 366 | NT5CP1 | NT5CP1 | H9_HAP1_T0097567
chr7_hap1 | 75274224 | 75274551 | + | -3.108585172 | NA | promoter-TSS (ENSG00000290832) | -promoter-TSS (ENSG00000290832) | 235 | ENSG00000290832 | ENSG00000290832 | H9_HAP1_T0441742

Sheet: H9_q20_hap2_enriched_peaks
Chr | Start | End | Strand | Peak Score | Focus Ratio/Region Size | Annotation | Detailed Annotation | Distance to TSS | Nearest PromoterID | Entrez ID | Nearest Unigene
chr7_hap2 | 76702856 | 76703517 | + | 2.110823599 | NA | promoter-TSS (H9_HAP2_G0121211) | -promoter-TSS (H9_HAP2_G0121211) | -283 | H9_HAP2_G0121211 | H9_HAP2_G0121211 | H9_HAP2_T0442278
chrX_hap2 | 133090173 | 133091004 | + | 1.141817623 | NA | Intergenic | Intergenic | 9042 | ENSG00000229015 | ENSG00000229015 | H9_HAP2_T0516347
