diekhans/pycbio/tests/progtests/geneCheck/input/AKRJ.gene-check.tsv

checkId | acc | chr | chrStart | chrEnd | strand | stat | frame | start | stop | orfStop | cdsGap | cdsMult3Gap | utrGap | cdsUnknownSplice | utrUnknownSplice | cdsNonCanonSplice | utrNonCanonSplice | numExons | numCds | numUtr5 | numUtr3 | numCdsIntrons | numUtrIntrons | nmd | causes
1 | g1.t1 | scaffold-18882 | 649 | 1410 | - | err | bad | no | no | 0 | 0 | 0 | 0 | 0 | 0 | 0 | 0 | 1 | 1 | 0 | 0 | 0 | 0 | ok | badFrame,noStart,noStop
2 | g2.t1 | scaffold-250138 | 8586 | 9495 | + | ok | ok | ok | ok | 0 | 0 | 0 | 0 | 0 | 0 | 0 | 0 | 1 | 1 | 0 | 0 | 0 | 0 | ok
3 | g3.t1 | scaffold-290908 | 139732 | 140200 | - | ok | ok | ok | ok | 0 | 0 | 0 | 0 | 0 | 0 | 0 | 0 | 1 | 1 | 0 | 0 | 0 | 0 | ok
4 | g4.t1 | scaffold-290908 | 92234 | 113571 | + | err | bad | no | no | 16 | 0 | 0 | 0 | 0 | 0 | 0 | 0 | 7 | 7 | 0 | 0 | 6 | 0 | ok | badFrame,noStart,noStop
5 | g5.t1 | scaffold-290908 | 117616 | 119263 | + | ok | ok | ok | ok | 0 | 0 | 0 | 0 | 0 | 0 | 0 | 0 | 1 | 1 | 0 | 0 | 0 | 0 | ok
6 | g6.t1 | scaffold-290908 | 120696 | 121650 | + | ok | ok | ok | ok | 0 | 0 | 0 | 0 | 0 | 0 | 0 | 0 | 1 | 1 | 0 | 0 | 0 | 0 | ok
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
