diekhans/pycbio/tests/progtests/vennChart/input/bool3.tsv

UCSC | WUSTL | Broad | Counts
0 | 0 | 0 | 0
0 | 0 | 1 | 2801
0 | 1 | 0 | 875
0 | 1 | 1 | 809
1 | 0 | 0 | 1364
1 | 0 | 1 | 119
1 | 1 | 0 | 809
1 | 1 | 1 | 1891
