diekhans/pycbio/tests/progtests/spreadSheets/expected/testTsvToXlsxHeaderXform/measurements.tsv

gene | p_value | _1st_count
BRCA1 | 0.01 | 5
TP53 | 0.03 | 8
