diekhans/pycbio/tests/progtests/spreadSheets/expected/testXlsxBasic/H9_q20_hap1_enriched_peaks.tsv

Chr | Start | End | Strand | Peak Score | Focus Ratio/Region Size | Annotation | Detailed Annotation | Distance to TSS | Nearest PromoterID | Entrez ID | Nearest Unigene
chr5_hap1 | 699943 | 700327 | + | -1.20244774584985 | NA | promoter-TSS (TPPP) | -promoter-TSS (TPPP) | 168 | ENSG00000289088 | ENSG00000289088 | H9_HAP1_T0375776
chr14_hap1 | 69301090 | 69301579 | + | -1.27038051836452 | NA | exon (NT5CP1, exon 1 of 1) | -exon (NT5CP1, exon 1 of 1) | 366 | NT5CP1 | NT5CP1 | H9_HAP1_T0097567
chr7_hap1 | 75274224 | 75274551 | + | -3.10858517240344 | NA | promoter-TSS (ENSG00000290832) | -promoter-TSS (ENSG00000290832) | 235 | ENSG00000290832 | ENSG00000290832 | H9_HAP1_T0441742
