diekhans/pycbio/tests/libtests/pycbio/hgdata/input/gencodeToGeneSymbol.tsv

transcriptId | symbol | geneId
ENST00000538324.2 | ABO | HGNC:79
ENST00000215794.8 | USP18 | HGNC:12616
ENST00000434390.1 | FAM230D | HGNC:53910
ENST00000413981.5 | DGCR6 | HGNC:2846
ENST00000331444.12 | DGCR6 | HGNC:2846
