diekhans/pycbio/tests/libtests/pycbio/hgdata/input/gencodeTranscriptSource.tsv

transcriptId | source
ENST00000382365.6 | ensembl_havana_transcript
ENST00000446723.4 | ensembl
ENST00000315357.9 | ensembl
