diekhans/pycbio/tests/libtests/pycbio/hgdata/input/gencodeTranscriptionSupportLevel.tsv

transcriptId | level
ENST00000315357.9 | 1
ENST00000382365.6 | 1
ENST00000446723.4 | 1
