diekhans/pycbio/(commit log)

2008-01-20 added filtering for clusters that contain a subset of genes
2008-07-21 still has mRNA/CDS order match code
    [hs_chrY.part.gbs, mm_chr13.part.gbs]
2008-10-05 use slots in immutable base class
2008-10-13 chained exception working
2009-09-04 fixed non-coding rna
    [hs_ref_GRCh37_chrY_part.gbs]
2010-10-16 improved mapping of CDS to mRNAs
    [mmu_ribFrameShift.gbs]
2010-10-16 annotate frame shifts
2010-10-16 add refseq filter option
2010-12-13 allow blank lines and comments in bed files
2011-05-08 switch from Bio.Genbank to Bio.SeqIO parser
2011-07-15 fixed test failures due to using chained exceptions
2011-08-16 added vennChart
    [bool3.tsv]
2012-04-19 added sonar stuff, but might not use
2012-05-18 first pass at pylint
    [pylint.cfg]
2013-02-17 changes test due to environment changes
    [exonsOnly.gbs]
2013-05-27 added hits for build test case
2013-07-11 added test case
2013-10-06 add __eq__ for psl
    [pylint.cfg]
2014-05-04 minor changes
    [AKRJ.gene-check.tsv]
2014-10-15 rename modules to start with lower case letter. Less confusing when classes are upper case
2014-12-07 fixed case senstiveing issues with tests
2015-01-01 renamed chr field to chrom
    [pylint.cfg]
2015-01-01 work on pylint
    [pylint.cfg]
2015-01-10 restructure test directories
    [AKRJ.gene-check.tsv, bool3.tsv, dupCol.tsv, geneCheck.tsv, geneCheckMulti.tsv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]
2015-07-25 added parse for NCBI assembly report file
2015-07-26 added program to convert assembly reports to other formats
2015-09-07 added assembly parser for Ncbi assemly summary
2015-10-17 switch to newer except syntax
2016-03-19 fake8 cleanup
    [pylint.cfg]
2016-08-26 added function to get attribute names for slotted classes
2017-03-06 switch to except as syntax
2017-03-06 add csvToTsv command
    [sra-run.csv, sraRunTest.tsv]
2017-03-06 added csvToTsv
    [sraRunTest.tsv]
2017-05-11 Frame is now a subclass of int
2017-05-11 merged Frame changes and added tests
2017-08-08 added support for gencode attrs in sqlite database; some flake8 fixes
    [gencodeAttrs.tsv]
2017-08-19 add gencodeSource
    [gencodeSource.tsv]
2017-08-19 added GencodeTranscriptSource support
    [gencodeTransSource.tsv]
2017-08-26 added gencode transcription support
    [gencodeTranscriptSource.tsv, gencodeTranscriptionSupportLevel.tsv]
2017-09-11 improve BED support
2017-09-14 added test for writing bed
2017-09-16 simplied Frame
2017-09-16 finish conversion to pipettor
2018-01-27 switch to apsw
2018-02-08 make atomicTmpFile thread and stale-file safe
2018-02-25 made PycbioException chaining work better on py2
2018-02-25 update PycbioException PY2 chaining so in works better
2018-03-17 add support of new gencodeAttrs proteinId
    [gencodeAttrs.tsv, gencodeAttrsPrev.tsv]
2018-04-22 added weird character and quoting tests cases
    [weird-chars.doc.csv, weird-chars.mac.csv, weird-chars.unix.csv]
2018-04-22 add dialect for printf-ed table files with unescaped quotes ; allow reading ms-dos newlines in py2
    [printfed-with-quotes.tsv, weird-chars.dos.csv]
2018-09-13 trim blank lines
    [sra-run.csv]
2018-10-31 track NCBI changes
2019-05-15 allow extension of bed classes
2020-04-07 added test case for special handling of /dev/stdout, but did not implement functionality yet
2020-04-07 allow atomic file to be in current directory
2020-04-27 fixed bug in trace where it died if frame had null
2020-05-11 add program to compute jaccard statistics on BED files
    [testPairings1.tsv, testStats1.tsv]
2020-05-11 added bestPairings report
    [testBestPairings1.tsv]
2020-05-11 added overlaping target stats
    [testBestNamePairing1.tsv, testBestOverPairing1.tsv, testBestPairings1.tsv, testNamePairing1.tsv, testNameStats1.tsv, testOverStats1.tsv, testPairings1.tsv]
2020-05-12 renamed bedJaccard to bedMappingCmp
    [testBestNamePairing1.tsv, testBestOverPairing1.tsv, testNamePairing1.tsv, testNameStats1.tsv, testOverStats1.tsv]
2020-05-15 generate histograph report
    [testHistoTm.tsv, testStatsTm.tsv]
2020-05-15 added base mapping rates
    [testStatsTm.tsv]
2020-05-15 make output consistent
    [testNameStats1.tsv, testOverStats1.tsv]
2020-05-16 added test cases
    [testBestNamePairingGalGal.tsv, testBestOverPairingGalGal.tsv, testNamePairingGalGal.tsv, testNameStatsGalGal.tsv, testOverStatsGalGal.tsv]
2020-05-17 added option to specify output column
    [testHistoGalGal.tsv, testStatsGalGal.tsv]
2020-05-17 allow control over float formating
    [testBestNamePairing1.tsv, testBestNamePairingGalGal.tsv, testBestOverPairing1.tsv, testBestOverPairingGalGal.tsv, testHistoGalGal.tsv, testHistoTm.tsv, testNamePairing1.tsv, testNamePairingGalGal.tsv]
2020-05-17 output more stats about multi-mappers
    [testStatsGalGal.tsv, testStatsTm.tsv]
2020-05-18 change TSV categories
    [testHistoGalGal.tsv, testHistoTm.tsv, testStatsGalGal.tsv, testStatsTm.tsv]
2020-05-19 added counts of scored transcripts
    [testNameStats1.tsv, testNameStatsGalGal.tsv, testOverStats1.tsv, testOverStatsGalGal.tsv]
2020-06-18 include unmapped in jaccard
    [testBestNamePairingSrcGalGal.tsv, testNamePairingSrcGalGal.tsv, testNameStatsSrcGalGal.tsv]
2020-06-18 updated excepted due to input change
    [testHistoGalGal.tsv, testStatsGalGal.tsv]
2020-06-18 moved hacky mapping analysis tools to a brach
    [testBestNamePairing1.tsv, testBestNamePairingGalGal.tsv, testBestNamePairingSrcGalGal.tsv, testBestOverPairing1.tsv, testBestOverPairingGalGal.tsv, testHistoGalGal.tsv, testHistoTm.tsv, testNamePairing1.tsv]
2020-06-19 fixed correct BED start/end
2020-09-07 added ability to use another class for bed recors
2020-09-08 fixed introduced in bed parser
2020-09-26 allow trace file to be already opened file
2020-09-26 fixed case where __file__ isn't avaiable and add tests
2020-11-16 added gene symbol for gencode sqlite3; simplified some code
    [gencodeToGeneSymbol.tsv]
2020-11-16 sqlite3 bed changes
2020-11-18 allow BED to be extended to add derived types
2021-03-23 screwed up last commit
2021-04-01 add tests for compress tab and bed files
2021-09-07 fixed bug in bed compat
2021-11-30 added frame factor
2022-07-11 fixed encode of None BED extra column
2022-09-04 fixed parsing of new capitalization of assembly report metadata names
2022-10-16 updated GeneGene stuff to use new checkId
    [AKRJ.gene-check.tsv, geneCheck.tsv, geneCheckDetails.tsv, geneCheckMulti.tsv]
2022-11-07 handle hash-space header
    [GCF_003709585.1.chromAlias.tsv]
2022-11-22 run existing tests with pytest
    [test_tsv.ReadTests.testAddColumn.tsv, test_tsv.ReadTests.testWrite.tsv]
2023-01-07 fixed argument prototypes
2023-11-27 use Frame class for genePred frame
2023-11-27 make Frame objects a set of singleton values
2023-11-27 fixed issues with having genePred frame as frame objects
2023-11-28 allow BED to not specify all columns and have them default upto the number of standard columns
2023-11-30 ensure that values in BED row are converted to string
2024-03-02 add Bed.getGaps()
2024-05-21 correctly set BED numStdCols when blocks are added afterwards
2024-07-12 Move parse and formatting of columns from TsvRow to TsvReader, allow column type parsing even if TsvRow is not being used
    [typesNan.tsv]
2024-09-26 added fixScores option to BED parsing
2025-01-09 added beginnings of a debug pretty-printer
2025-02-04 para fixes
2025-02-05 don't ssh when parasol is on local host; don't hied stderr on para make
2025-04-19 add a test, although it wasn't a bug
    [asmReportToTsvBasicTest.tsv, asmReportToTsvWithMetaTest.tsv]
2025-05-06 gave caller more control of ErrorHandler print stacks
2025-05-23 Removed redundent code, and in one case incorrect, code to update PSL counts. Simplified pslMap code
2025-07-05 added debug print
2025-07-10 never dump stack traces on SystemExit
2025-07-10 previous SystemExit handling was not correct, need to print nothing and continue the error
2025-08-10 conversion to pytest
    [test_tsv.py::testAddColumn.tsv, test_tsv.py::testWrite.tsv]
2025-10-09 added sra-map-tool tests
    [SRX14530460-SraRunInfo.csv, SRX2013614-SraRunInfo.tsv]
2025-10-16 add support for threaded SRA download
2025-11-11 remove spreadsheet file name prefix for output tsv and add tests
    [H9_haplotype_enriched_peaks_atac-seq.xlsx, H9_q20_hap1_enriched_peaks.tsv, H9_q20_hap2_enriched_peaks.tsv]
2026-01-05 add function to extend BED extra columns
2026-01-08 generated more BED tests
2026-02-22 addedss bed tests
2026-03-21 add TsvWriter class and fixes ome consistency problems
    [test_tsvWriter.py::testWriteColumns.tsv, test_tsvWriter.py::testWriteFromDicts.tsv, test_tsvWriter.py::testWriteFromLists.tsv, test_tsvWriter.py::testWriteFromNamedtuples.tsv, test_tsvWriter.py::testWriteFromTsvRows.tsv, test_tsvWriter.py::testWriteNoTypeMap.tsv, test_tsvWriter.py::testWriteNoneValues.tsv, test_tsvWriter.py::testWriteToFh.tsv]
2026-03-30 automatically write TSV header
    [test_tsvReader.py::testWrite.tsv, test_tsvWriter.py::testWriteColumns.tsv]
2026-04-02 switch to keyword-only
2026-05-03 csvToTsv renamed to csv-to-tsv, now can specify delimiter
    [sra-run-semi.csv, sra-run.csv, sraRunTest.tsv]
2026-05-16 spreadsheet TSVs are now UNIX EOLN
    [H9_q20_hap1_enriched_peaks.tsv, H9_q20_hap2_enriched_peaks.tsv]
2026-06-27 add option to get all assembly report info into a TSV
    [asmReportToTsvAllMetaTest.tsv, asmReportToTsvWithMetaTest.tsv]
2026-07-16 no stack trace on no ids
2026-07-16 tsv-to-xlsx: add --numbers and --max-width, plus round-trip prog test
    --numbers converts int/float-looking cells to real Excel numbers;
    --max-width (default 16) auto-fits each column to its widest cell.
    Added a tsv-to-xlsx round-trip test to the spreadSheets prog tests.
    [genes.tsv, samples.tsv]
2026-07-18 added options to tsv-to-xlsx to modify headers
    [Genes.tsv, Samples.tsv, measurements.tsv]
2026-07-19 spreadsheet tests
    [dataset_v1.genes.tsv, dataset_v1.samples.tsv]
2026-07-23 BrowserDirDynamic: fix current-row highlight on link click
    The rowClick handler was passed as a Tabulator constructor option, which
    Tabulator 6 silently ignores (event callbacks must be registered via
    table.on()). Register it with _dirTable.on("rowClick", ...) so clicking a
    row's link highlights that row as the location currently shown in the
    browser frame.
2026-07-24 BrowserDirDynamic: numeric range filter and column alignment
    Add per-column filter="range" giving a numeric min/max header filter
    (custom two-input editor over a numeric field, cleared when both bounds
    are empty). Add a colDefs "align" option (hozAlign/headerHozAlign);
    range columns default to right-aligned. Hide the number-input spinner
    arrows on the range filter inputs.
    Exercise the range filter and right-alignment via a numeric length
    column in testDynamicGenes.
2026-07-24 BrowserDirDynamic: fix range filter clearing itself on keystroke
    The custom range header-filter editor returned a <span> wrapper, but
    Tabulator's live filter binds keyup to the returned element and calls
    success(element.value); a span has no value, so success(undefined) cleared
    the filter right after each keystroke. Expose the {min,max} object via a
    value getter on the wrapper so Tabulator's own path sets the filter too.
2026-07-25 BrowserDirDynamic: fix table shrinking as the window widens
    Every fit column was given a definition width, so no column was left in
    Tabulator's fitColumns flex pool; with fit columns also carrying
    widthShrink, the layout took leftover space as overflow (|gap| + free
    space) and squeezed all columns, the more so the wider the window.
    A fit column that also expands now takes the measured size as its
    minWidth and keeps flexing; a plain fit column is pinned with both the
    definition width and setWidth (mutating the definition alone does not
    resize what is rendered). Dropped widthShrink from fit columns; an
    explicit shrink in colDefs still applies.
    Also quote the frameset rows/cols attribute and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
2026-07-26 BrowserDirDynamic: regexp column filters and a filter-help button
    Text filters, both the per-column boxes and the global search, are now
    case-insensitive regular expressions matched anywhere in the value;
    patterns are compiled once rather than per row. A pattern that will not
    compile, as while one is being typed, falls back to a substring match so
    the table does not blank out. regexpFilters=False keeps the old
    substring matching.
    A "?" button by the search box toggles a description of how the page
    filters, adapted to the page (regexp or substring, min/max only with
    range columns, search only when enabled); filterHelp is optional HTML
    appended to it. The bar is emitted whenever there is a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
2026-07-27 BrowserDirDynamic: move client code to browserDirDynamic.js
    The JavaScript was over 200 lines of browserDir.py. It now lives in
    browserDirDynamic.js beside the module, shipped as package data and read
    with importlib.resources, then inlined into each generated page after
    that page's _colSpec/_tableData/_opts, so pages stay self-contained.
    Also add a filter-help reminder that a value is excluded with a
    look-ahead, ^(?!ok$).* matching everything other than ok.
2026-07-28 parasol: BatchStats parses the sick-machines line, and the failed/hung counts
    `para check` ends with paraHub's sick-node summary when a batch has one:
    total sick machines: 3 failures: 9
    BatchStats had no case for it, so the whole parse raised "don't know how to
    parse para check output line" -- losing every statistic exactly when a batch had
    failed, which is when they are wanted. It is two counts on one line, so it does
    not fit the `key: value` map: split(":") gives ["total sick machines",
    " 3 failures", " 9"]. Now parsed into sickMachines / sickFailures.
    Two adjacent bugs fixed while there: the `failed %d times: %d` and
    `hung (> %d minutes): %d` branches assigned 0 instead of the pa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
2026-07-31 parasol: Para stderr is configurable per-instance
    Para takes a stderr argument (default fd 2) controlling where para's
    stderr goes, replacing make()'s '/dev/stderr' hack and the previous
    capture-everything default. freeBatch() and clearSickNodes() still
    force pipettor.DataReader, since they test ex.stderr for "Batch not
    found".
2026-08-02 browserDir: the page description behind a ? beside the title
    A dynamic directory could be left with almost no table by its own header. The
    page description was emitted raw into a full-height flex column, so it took
    whatever height it wanted: on a family page whose header explains why the family
    is under review -- caveats, member list, each member's modal copy count -- the
    table was a sliver.
    It is now hidden behind a ? beside the title, shown as a bordered panel capped at
    40vh that scrolls itself. Hidden rather than merely capped: a scrolled box still
    spends a quarter of the frame on text that is read once, and these pages are
    usually a frameset with the directory in the short bottom fram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
2026-08-02 browserDir: give the table back to the frame when the frame is resized
    Tabulator sizes its scrolling area in pixels when it is built. The div holding
    it is a flex item and grows with the frame, but the table keeps the height it
    was born with -- so dragging the frameset divider to make the directory taller
    added blank space under the table instead of showing more rows.
    A debounced redraw on window resize and on the element's own ResizeObserver.
    Plain redraw(), not redraw(true): only the height needs recomputing, and a full
    redraw would throw away the column widths the reader had dragged.
2026-08-04 pycbio.snakemake: workflow support for stages that fan out over a cluster
    From the miRNA-HPRC workflow's lib/snakelib.py, split by concern:
    ProductScan (per-product staleness + the stamp that makes "nothing to do"
    cheap), BatchRunner with ParasolBatch/SlurmBatch behind one contract, and
    per-rule timing. fast_remove goes to sys.fileOps, being general file work.
    Names stay snake_case so existing Snakefiles are an import swap. Detached
    `rm -rf` now runs through pipettor with setsid rather than os.system+nohup,
    and sbatch failures chain into a PycbioException naming the per-task logs.
2026-08-06 browserDir: openFirstRow, opening the frame where the first row points
    A directory page whose rows are the point opened its browser frame on defaultDb at
    its default position -- the reference, which is the one genome such a page is not
    about. openFirstRow opens it where the first row's first link points instead, as
    though the reader had clicked it, and marks that row current so it carries the same
    highlight a clicked row gets.
    the URL comes from the row's own anchor, not from coordinates rebuilt here, so it
    cannot drift from what a click would follow.
    the hub and custom-track args are appended: mkAnchor leaves those to mkDefaultUrl,
    and a hub genome does not load without them.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
2026-08-19 browserDir select filter: choice order, emptyChoice, earlier validation
    From reviewing 3ade3a3:
    - the choice sort key was not total, so choices tying on the number ("1", "1.0")
    or on case came out of the set and changed between runs
    - emptyChoice=None enabled the choice labelled None, the opposite of the ask;
    anything false now means no choice
    - colDefs are checked in the constructor, so a bad filter type no longer raises
    after write() has created the frameset, and selectValues/emptyChoice require
    filter="select" rather than being dropped silently
    - tests for each, plus a node driver that runs a generated page's own JavaScript;
    the expected-output tests only compared it as text
    nc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
2026-08-19 fix the bugs a scan of a vendored copy turned up
    Data loss and crashes, each reproduced before and after:
    - tabFile, fileOps.iterLines and iterRows took the last character off the last
    line of a file that does not end in a newline
    - a BED of 7, 10 or 11 columns consumed the trailing columns as standard ones and
    then wrote a fabricated block; with no numStdCols such a row is now the widest
    width whose field groups are complete plus extra columns, and it round-trips.
    numStdCols=7 carries thickStart; 10 and 11 can not be parsed, since blocks need
    all three block columns, and the error names the widths that work. A BED with
    real blocks may still be written at those widths.
    - --log-c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
2026-08-27 issues.org: close out the vendored-copy scan
    - the TsvRow column-name shadowing is the existing "clean up TsvRow" entry, not a
    second one here
    - a declared BED10 or BED11 is not a valid BED, so it is owed no round trip and Bed
    will not keep raw block columns beside the parsed blocks
    Claude-Session: https://claude.ai/code/session_01MgnWFiggKpdCxFixasRUPi
2026-08-29 ProductScan.pending: a product older than its source is pending too
    Existence was the whole test, so a source rebuilt in place left a product that
    exists and is wrong, and the stage handed it on. In miRNA-HPRC an assembly's CAT
    annotation was regenerated nine minutes after its loci BED was built from the
    previous one; the BED existed, the stage skipped it, and every stage below
    reported success over a locus assigned to the wrong gene for a day. A
    from-scratch rebuild found it, which is what those are for.
    pending() takes an optional sources callable, item -> the paths its products are
    built from, and reports a product missing OR older than the newest of them. A
    missing source is ignored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
2026-09-11 bed: clamp score to 0 to 1000 on read and write, rawScores to opt out
    A BED score is an int in the range 0 to 1000, and the browser truncates a float
    and clamps one outside the range. pycbio passed the value through, so an
    out-of-range score reached the file. bedScoreFix is now the default on both read
    and write; rawScores keeps the value exactly as written, via bedScoreParse.
    FLAIR carried a local min(1000, score) in its copy of bed.py, which missed the low
    end; it can drop it.
    Claude-Session: https://claude.ai/code/session_01GyN61X8HGuLGzSi6Pwq1mj
